moisesStevend/Health-Recover/README.md

# Health-Recover
Proyecto Health Recover

_Desarrollo de un sistema de IoT para la adherencia a la terapia de
 rehabilitación en personas con ACV
 Laboratorio de Innovación en Salud - UPCH_

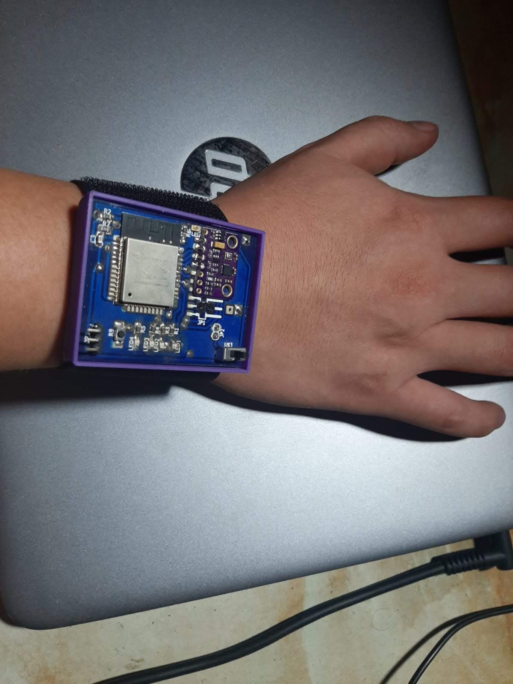
[picture p1: EVIDENCIAS/fotos/HR_fotos/health_recover.jpg]
Health Recover
