moisesStevend/Health-Recover/DOCUMENTOS/informes/ppt/pres_serendipity.pdf

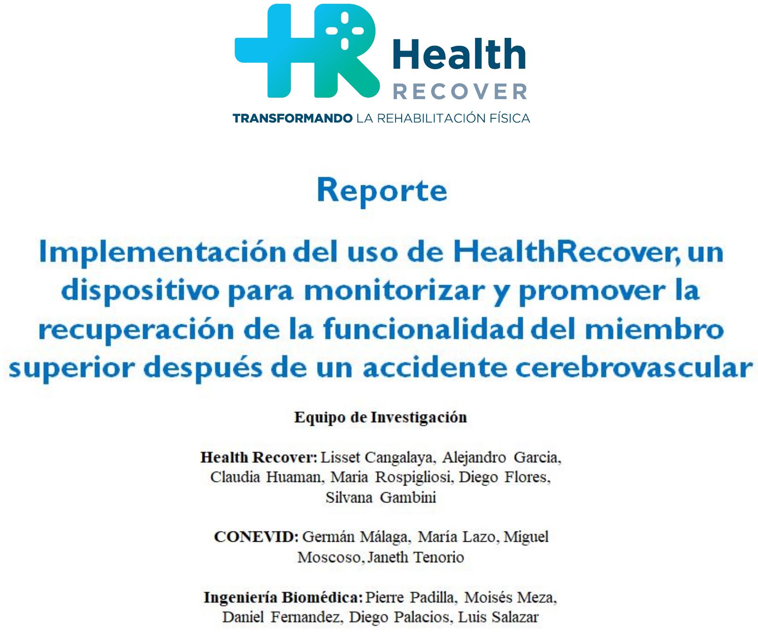
[picture p2: page 1]

# Nueva propuesta de tecnología wearable para Health Recover

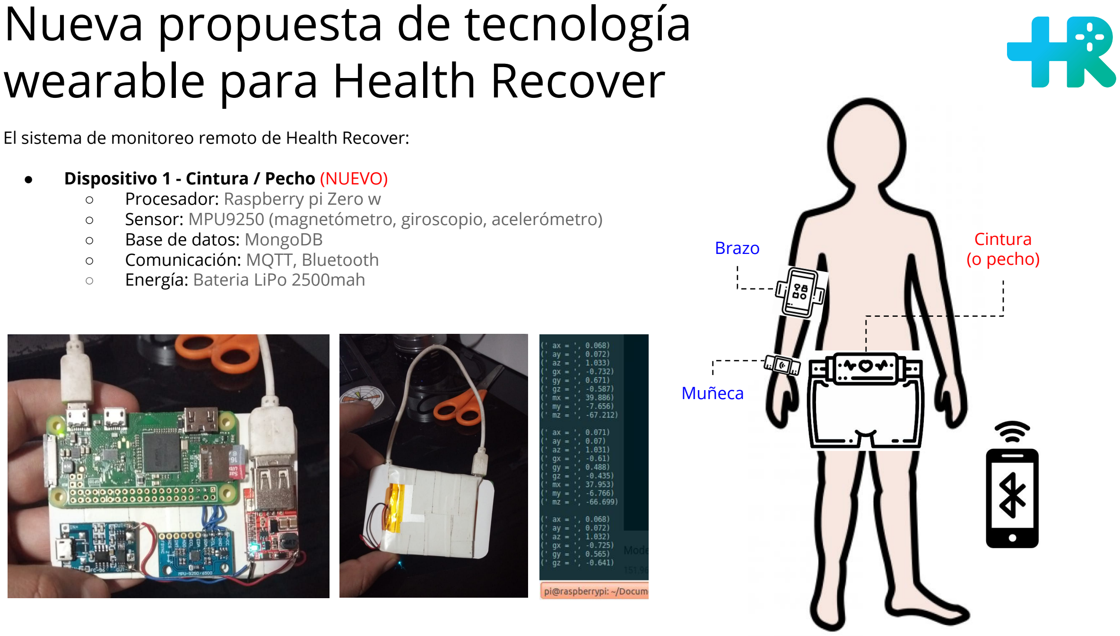
[picture p3: page 2]

El sistema de monitoreo remoto de Health Recover:

- Dispositivo 1 - Cintura / Pecho (NUEVO)
- Procesador: Raspberry pi Zero w
- Sensor: MPU9250 (magnetómetro, giroscopio, acelerómetro)
- Base de datos: MongoDB
- Comunicación: MQTT, Bluetooth
- Energía: Bateria LiPo 2500mah

Cintura
(o pecho)

Muñeca

Brazo

# Nueva propuesta de tecnología wearable para Health Recover

El sistema de monitoreo remoto de Health Recover:

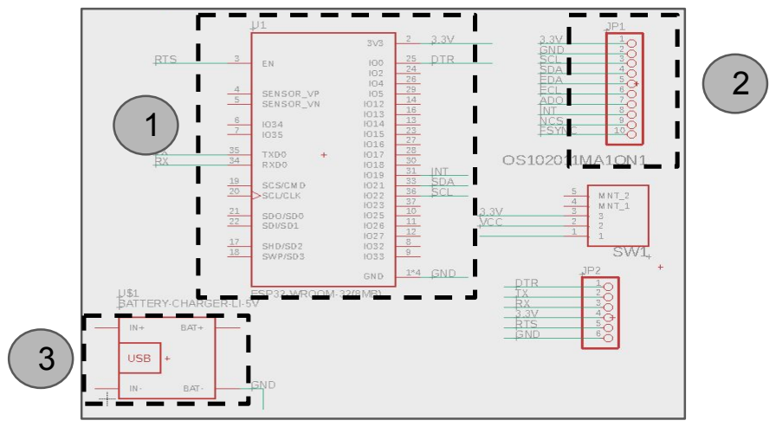
[picture p4: figure]

- Dispositivo 2 - Brazo (ACTUALIZADO)
- Procesador: ESP8266 (1)
- Sensor: MPU9250 (2 - sólo conectores)
- Comunicación: MQTT
- Energía: Bateria LiPo 1000mah (3 - sólo conectores)
- Dispositivo 3 - Muñeca (ACTUALIZADO)

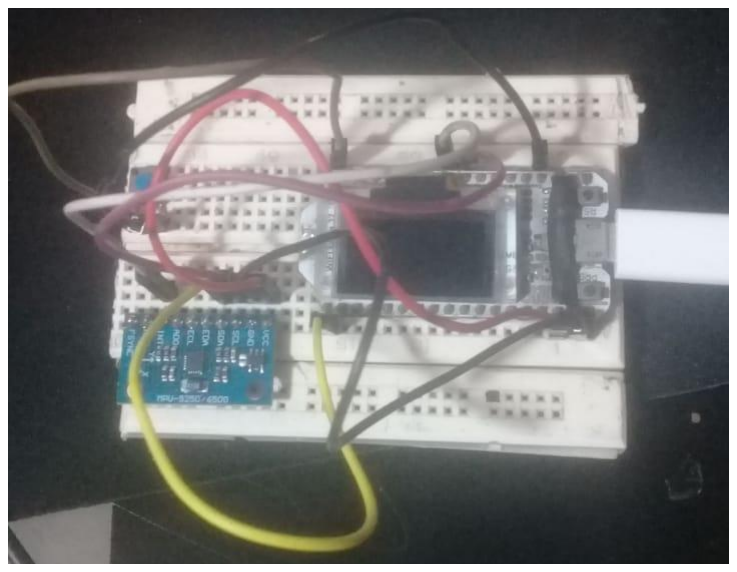
[picture p5: figure]
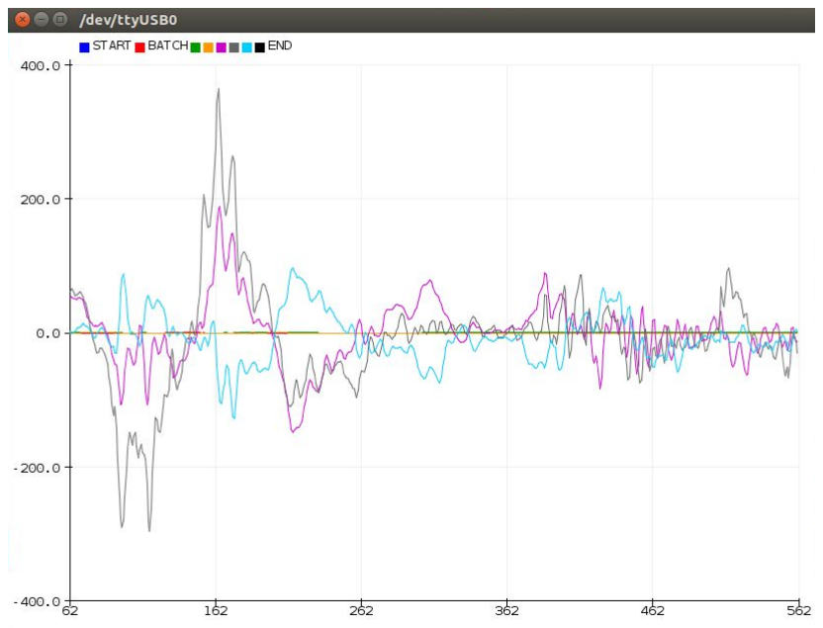
[picture p6: figure]
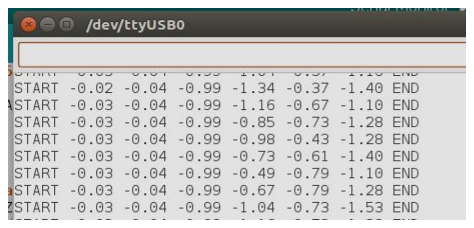
[picture p7: figure]

- Procesador: ESP8266
- Sensor: MPU9250
- Comunicación: MQTT

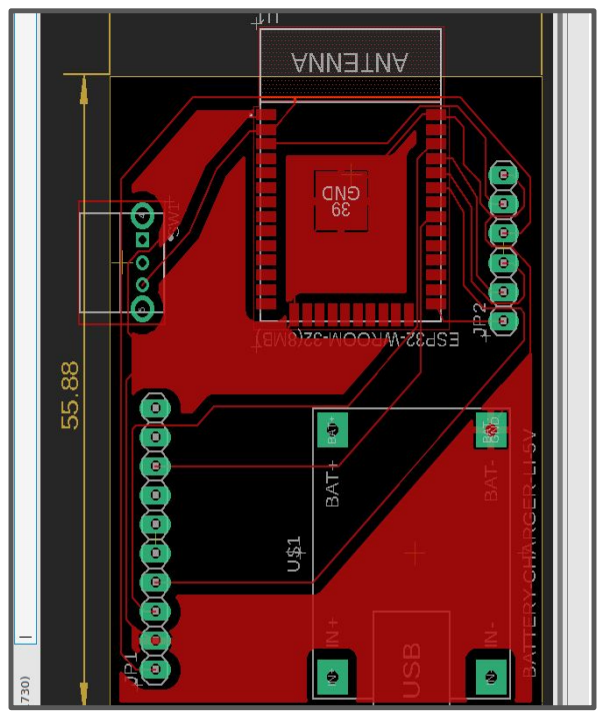
[picture p8: figure]

- Energía: Bateria LiPo 1000mah

52 mm

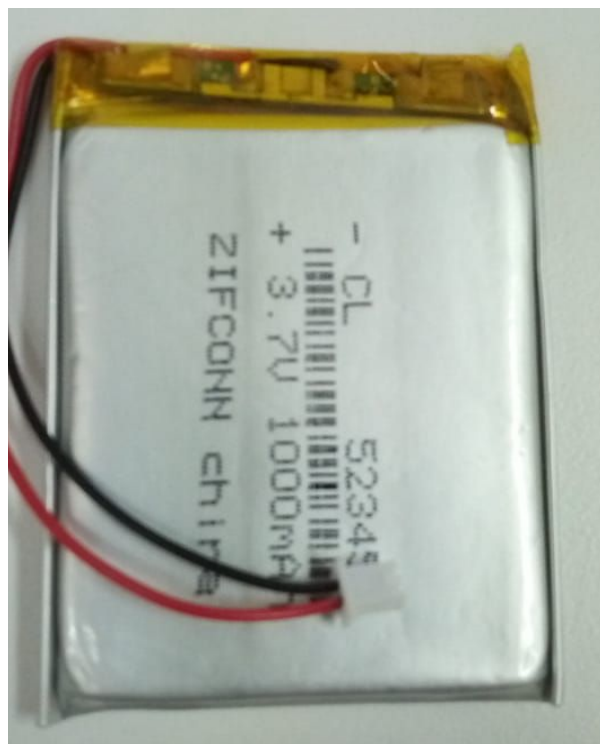
[picture p9: figure]

35 mm

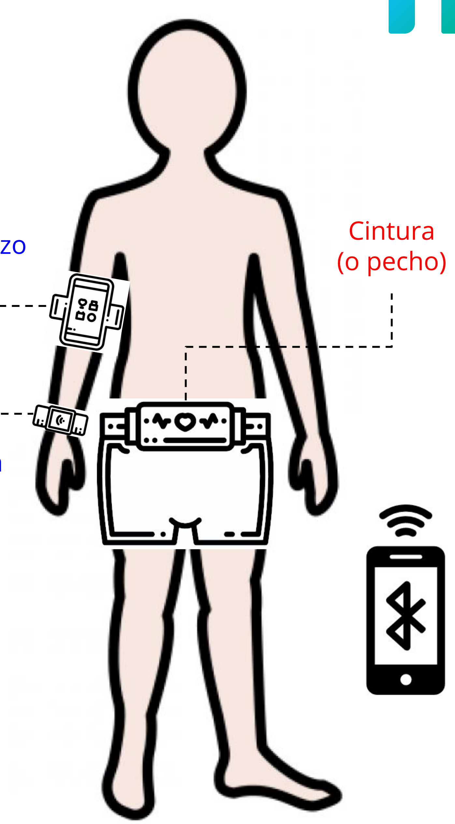
[picture p10: figure]
Cintura (o pecho)

Muñeca

Brazo

## Referencias

SWORD Health [Internet]. SWORD Health. 2019 [cited 2019 Dec 9]. Available from: https://swordhealth.com/

Kickstarter. FIVIS: Wearable Sensor Belt Helps You Develop Proper Posture [Internet]. 2019 [cited 2019 Dec 9]. Available from: https://www.kickstarter.com/projects/thecore/fivis-weak-core-bad-posture-and-back-p ain-relief-solution (https://www.kickstarter.com/projects/thecore/fivis-weak-core-bad-posture-and-back-pain-relief-solution)

Kickstarter. Flexr: Control Technology with Your Muscles [Internet]. 2019 [cited 2019 Dec 9]. Available from:
https://www.kickstarter.com/projects/1492366788/flexr-control-technology-with-yourmuscles (https://www.kickstarter.com/projects/1492366788/flexr-control-technology-with-your-muscles)

Kickstarter. 1Coach: Wearable that trains you to run like a Pro [Internet]. 2019 [cited 2019 Dec 9]. Available from: https://www.kickstarter.com/projects/46265006/1coach-your-personal-ai-powered-ru nning-coach (https://www.kickstarter.com/projects/46265006/1coach-your-personal-ai-powered-running-coach)

Chien C, Xia J, Santana O, Wang Y, Pottie GJ. Non-linear complementary filter based upper limb motion tracking using wearable sensors. In: 2013 IEEE International Conference on Acoustics, Speech and Signal Processing. 2013. p. 963–7.

Miezal M, Taetz B, Bleser G. On Inertial Body Tracking in the Presence of Model Calibration Errors. Sensors. 2016 Jul;16(7):1132.

Ordóñez FJ, Roggen D. Deep Convolutional and LSTM Recurrent Neural Networks for Multimodal Wearable Activity Recognition. Sensors. 2016 Jan;16(1):115.
