moisesStevend/Health-Recover/DOCUMENTOS/informes/mensuales/nov.pdf

avances meses Octubre-Noviembre Elaborado por Moises Stevend Meza Rodriguez

Se ha realizado lo siguiente:

## Octubre

Semana 01:
- Se probó un enlace mqtt entre los 2 esp8266, verificando que trabajen conjuntamente.
- Se probó el software ROS en ubuntu 18, pero no se obtuvo avances ya que el software no contaba con compatibilidad con la kinect v1
- Se probóC# por se el lenguaje que mantiene compatibilidad con la kinect v1. Este lenguaje nos podría servir si queremos algún punto en particular.
- Se instaló C# en visual studio y se procedió a programar un script de reconocimiento de trayectorias.

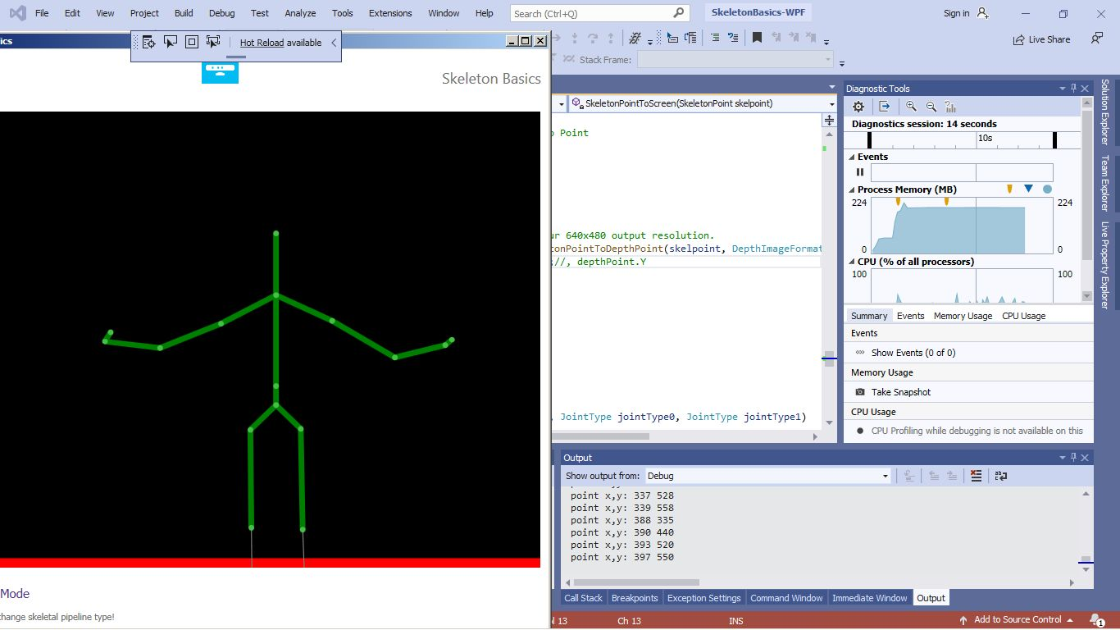
[picture p19: figure]

FIG.1- Esqueleto mediante líneas y puntos mediante C#

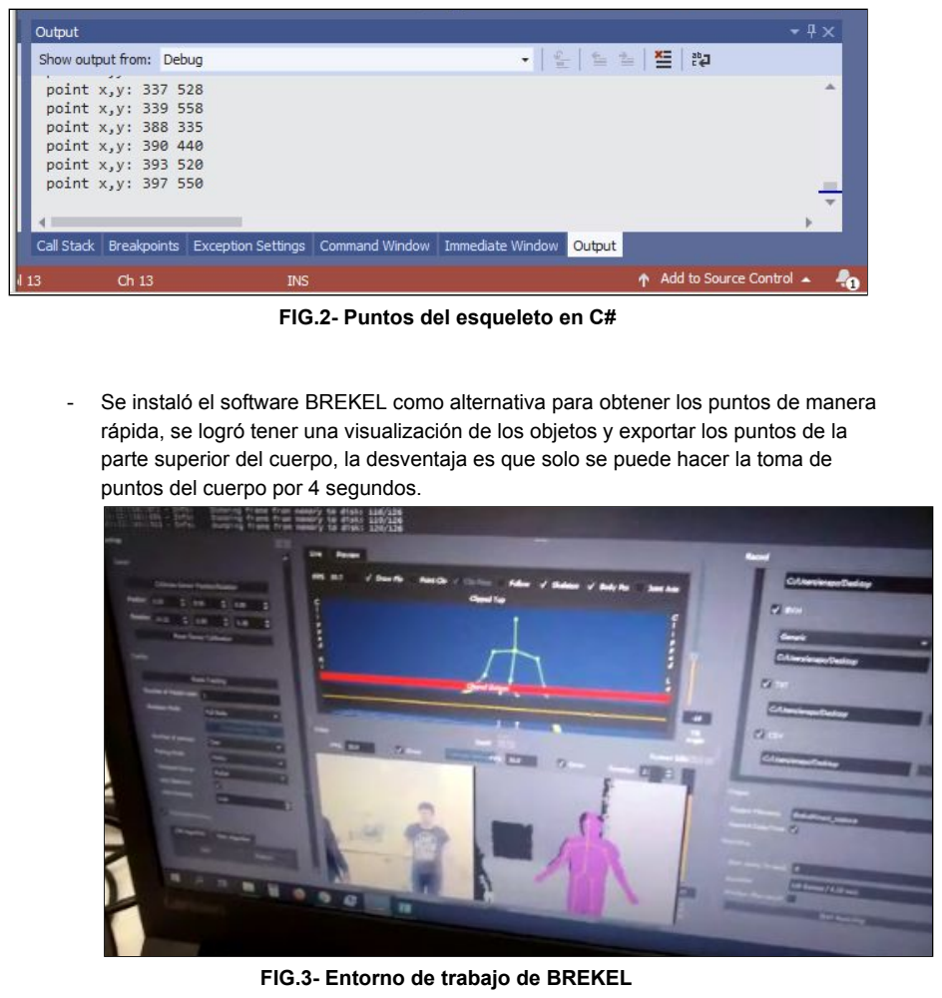
[picture p20: page 2]

FIG.2- Puntos del esqueleto en C#

- Se instaló el software BREKEL como alternativa para obtener los puntos de manera rápida, se logró tener una visualización de los objetos y exportar los puntos de la parte superior del cuerpo, la desventaja es que solo se puede hacer la toma de puntos del cuerpo por 4 segundos.

FIG.3- Entorno de trabajo de BREKEL

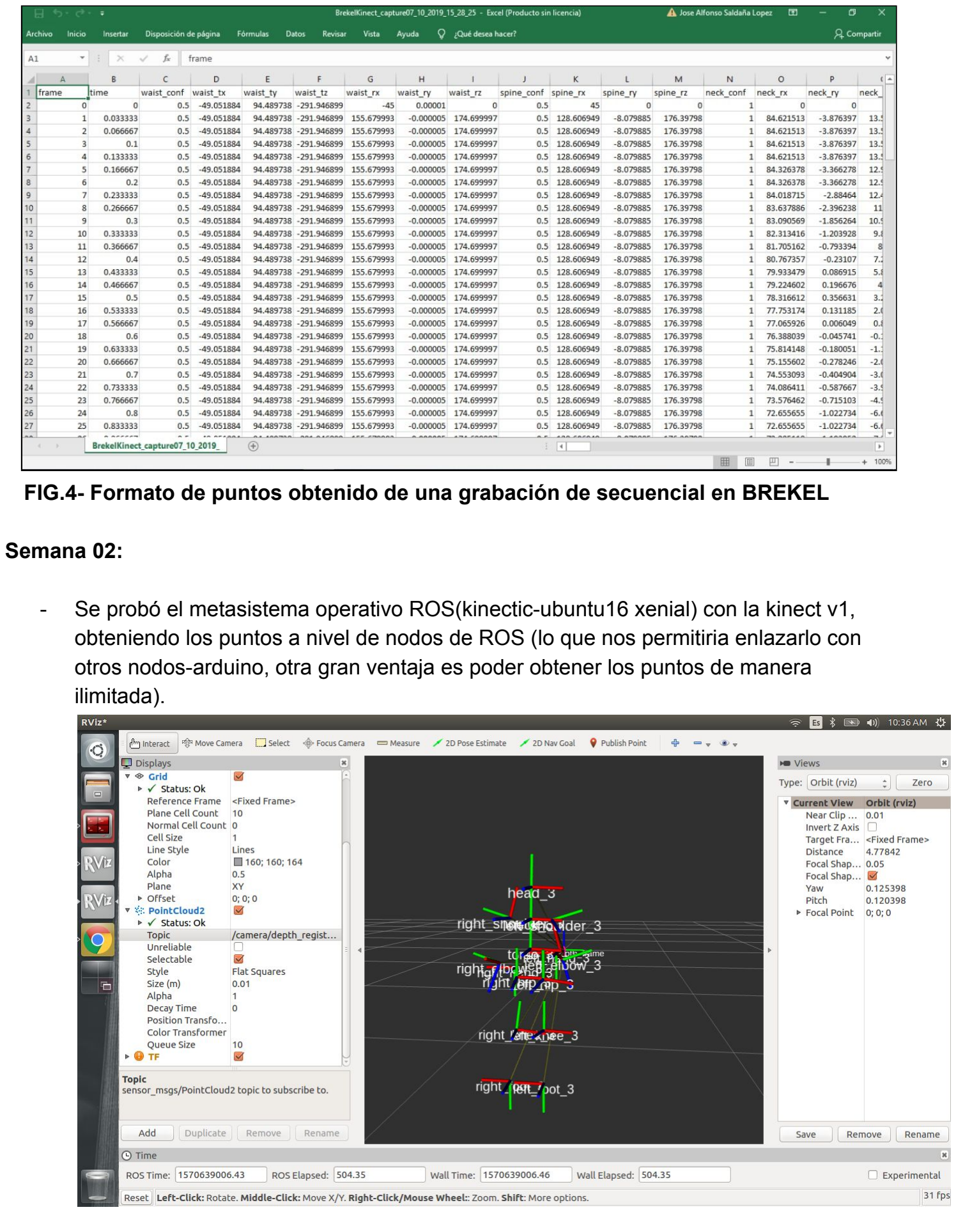
[picture p21: page 3]

FIG.4- Formato de puntos obtenido de una grabación de secuencial en BREKEL

Semana 02:

- Se probó el metasistema operativo ROS(kinectic-ubuntu16 xenial) con la kinect v1, obteniendo los puntos a nivel de nodos de ROS (lo que nos permitiria enlazarlo con otros nodos-arduino, otra gran ventaja es poder obtener los puntos de manera ilimitada).

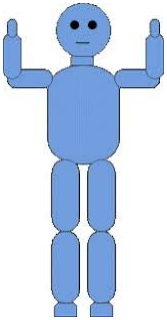
[picture p22: figure]

Fig .- Posición de inicio: “Pose PSI”

Se deja algunos enlaces usados:
- https://www.reddit.com/r/ROS/comments/6qejy0/openni_kinect_installation_on_kinetic_indigo/ (https://www.reddit.com/r/ROS/comments/6qejy0/openni_kinect_installation_on_kinetic_indigo/)
- https://answers.ros.org/question/10325/how-do-i-run-the-openni_tracker/
- http://dougsbots.blogspot.com/2012/02/ros-kinect-skeleton-tracking.html
- https://github.com/arnaud-ramey/NITE-Bin-Dev-Linux-v1.5.2.23
- http://mitchtech.net/ubuntu-kinect-openni-primesense/
- Se probó el MYo-armband y se obtuvo los valores del IMU en ROS kinetic.

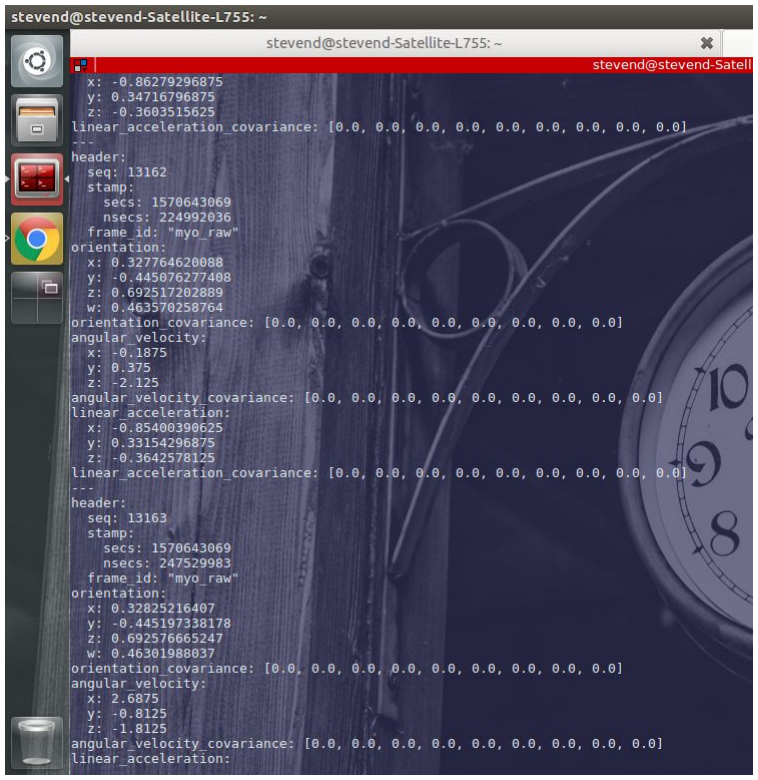
[picture p23: figure]

Fig Datos obtenidos de la MYO ARM band

- Adquisición de datos del mpu mediante mqtt con la laptop.
- Se tuvo una reunión sobre las modificaciones que tendrá las futuras versiones.
- Se instaló raspbian en la raspberry pi3
- Se creó un script para adquirir datos del mpu6050

Datos raspberry pi3:

❖ Red wifi: LAB.ING.BIOMEDICA
❖ Acceso via ssh: ssh -X pi@healthrecoverpi ❖ Username: pi
❖ Password: MicroRobotica19

semana 03:

- Se hizo una pcb para la conexión entre mpu6050 y rpi3
- Se optó por rediseñar el dispositivo para un mejor control de trayectorias, basado en un esp32 y un mpu9250.
- Se diseñó la nueva arquitectura de comunicación de los dispositivos hardware y el smartphone.

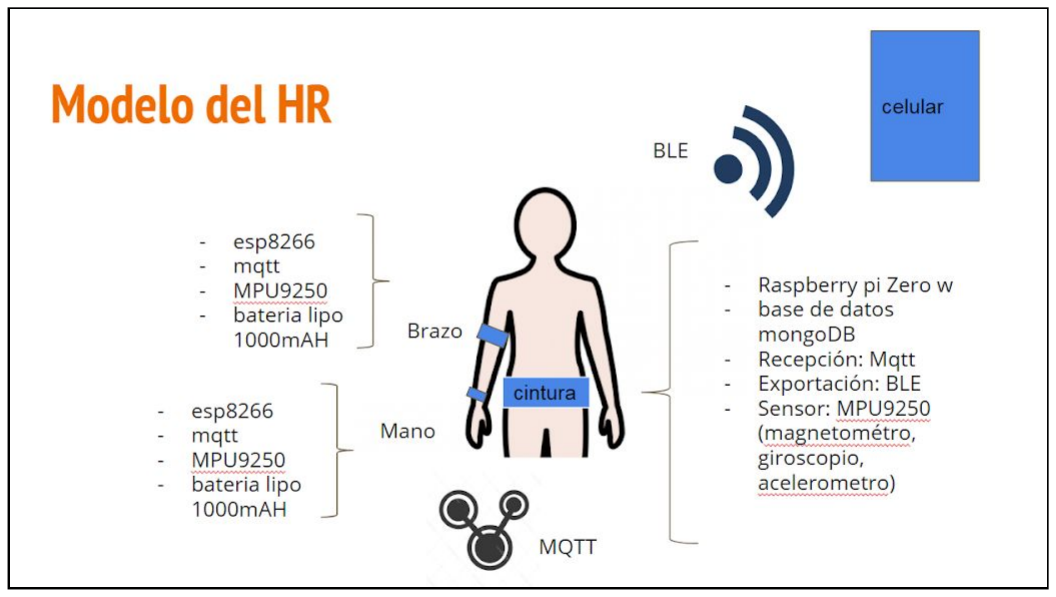
[picture p24: figure]

Fig. Nuevo movelo del HR

Semana 4:

- Pruebas de enlace entre el raspberry pi y los nodos del health recover.
- Se probó la instalación del ROS en el raspberry pi.
- Se analizó la identificación de patrones en WEKA
- Se analizó la Visualización de Datos en Python
- Se analizó la Base de Datos en MongoDB
- Se realizaron las compras para el nuevo dispositivo.

## Noviembre

Semana 1
- Se coordino las compras restantes.
- Se validó el nuevo modelo de hardware
- Se instaló ROS es el raspberry pi zero

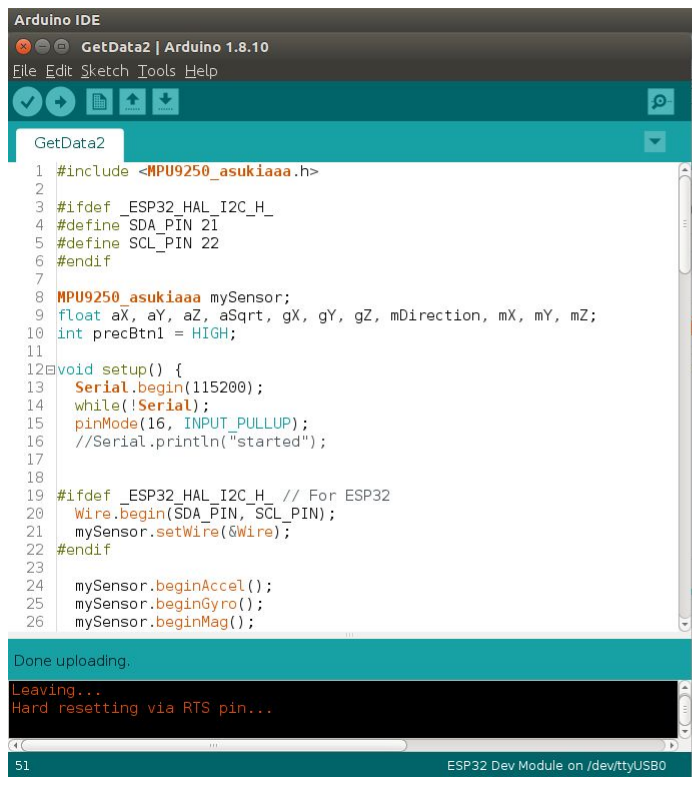
[picture p25: figure]
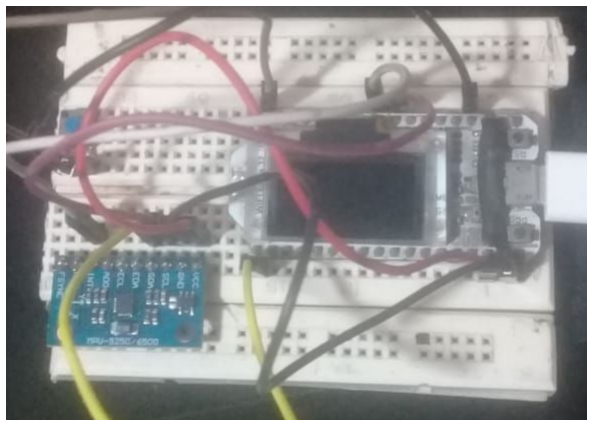
[picture p26: figure]

Fig.- Código base y circuiteria para el esp32 y el mpu9250 Semana 2:
- Se analizo patrones de la data obtenida del mpu9250
- Se empezó a implementar algoritmos de IA para obtener secuancias de movimientos.

Semana 3:
- Se realizo el diseño de la versión 2 del HR en eagle, se desarrolló en un modelo de 2 capas para los nodos del brazo.

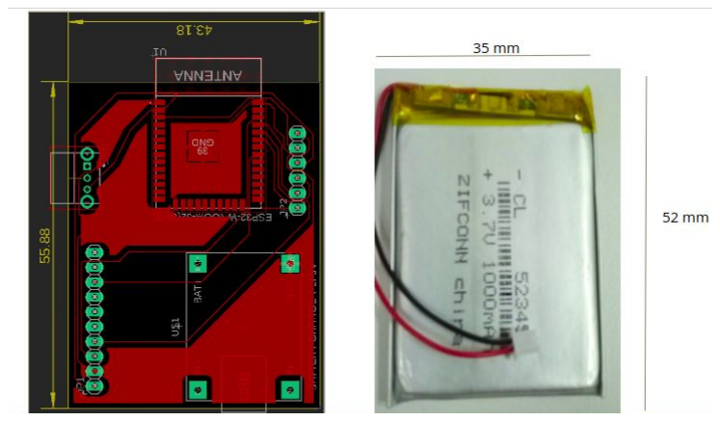
[picture p27: figure]

Fig.- Diseño del PCB para los nodos del brazo.

semana 4:
- Desarrollo del prototipo de HR - cintura.
- Adquisición de valores de los nodos.
- Prueba de todos los algorithmos desarrollados hasta la fecha en ela raspberry pi zero w.

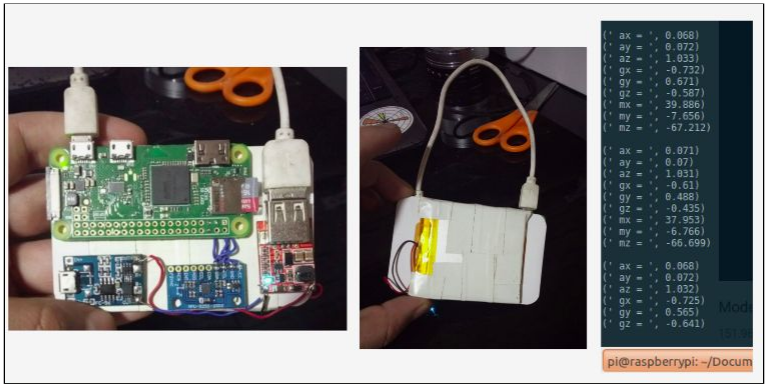
[picture p28: figure]

Fig.- Circuiteria del nodo central y adquisición de datos de su mpu9250

## Resumen

Desarrollo del hardware.-
En cuanto al desarrollo del hardware se opto por pasar el dispositivo central esp8266 a un esp32, además se opto por cambiar el mpu6050 por un mpu9250. Se completo la verificación de la comunicación y se desarrollo un modelo de pcb en eagle para la parte de los nodos del brazo. Se optó por adicionar un nodo central para mejorar el procesamiento de los datos, este nodo central esta basado en una raspberry pi zero w. Se desarrollo un esquema electrónico para la comunicación entre el raspberry pi, mpu9250 y la electronico suficiente para el buen desempeño.

Grabación de movimientos.-
Se opto por trabajar con el metasistema operativo ROS(Robotics Operating System) y la Kinect v1.0 para la optención de los movimientos y su análisis.

Compra de componentes para tarjetas. Se llego a completar las compras para esta segunda versión del HR. Se requerira componentes adicionales para la versión final del pcb.

Grabaciones de movimientos.-
Se grabó unas secuencias mediante ROS y Knect y se estuvo prograbando el reconocimiento de patros, también se completo los códigos de programación para los nodos del brazo. El algorithmo aún esta en depuración.
