moisesStevend/Health-Recover/DOCUMENTOS/informes/mensuales/set_oct.pdf

### Informe de Avances Moises Stevend Meza Rodriguez

Dia 28/09/19
- Se tuvo una conversación con el desarrollador de la aparte de hardware del Health-Recover Joaquín Verastegui.
- Se analizó los esquemáticos del hardware.
- Se comprobó el funcionamiento del hardware.
- Se puso operativo las tarjetas Health-Recover.
- Se analizó la arquitectura de comunicación del proyecto.

Día 30/09/19
- Se monitoreo el avance según el cronograma establecido.
- Se coordino el uso de la plataforma para programar los algoritmos.

Día 1/10/19
- Se probó la kinect con su sdk y el toolkit developer 1.8.
- Se empezó a probar enlazarlo con algún lenguaje de programación para obtener los puntos, se empezo con pykinect pero no se obtuvo los resultados esperados.

Día 2/10/19
- Se probó diferentes lenguajes para obtener los puntos, pero no se logró enlazar a ningún lenguaje.

Día 3/10/19
- Se probó un enlace mqtt entre los 2 esp8266,verificando que trabajen conjuntamente.

Día 4/10/19
- Se probó el software ROS en ubuntu 18, pero no se obtuvo avances ya que el software no contaba con compatibilidad con la kinect v1

Día 5/10/19
- Se tuvo una reunión para ver el seguimiento de los proyectos según el cronograma.
- Se instaló ubuntu12.04 para probar la versión libre de la kinect, no se obtuvo avances ya que no existe soporte para esa versión de ubuntu.

Día lunes 07/10/19
- Se instaló diferentes drivers para el reconocimiento del sdk-kinect modo developer, con el fin de poder programarla, se uso windows como sistema operativo.

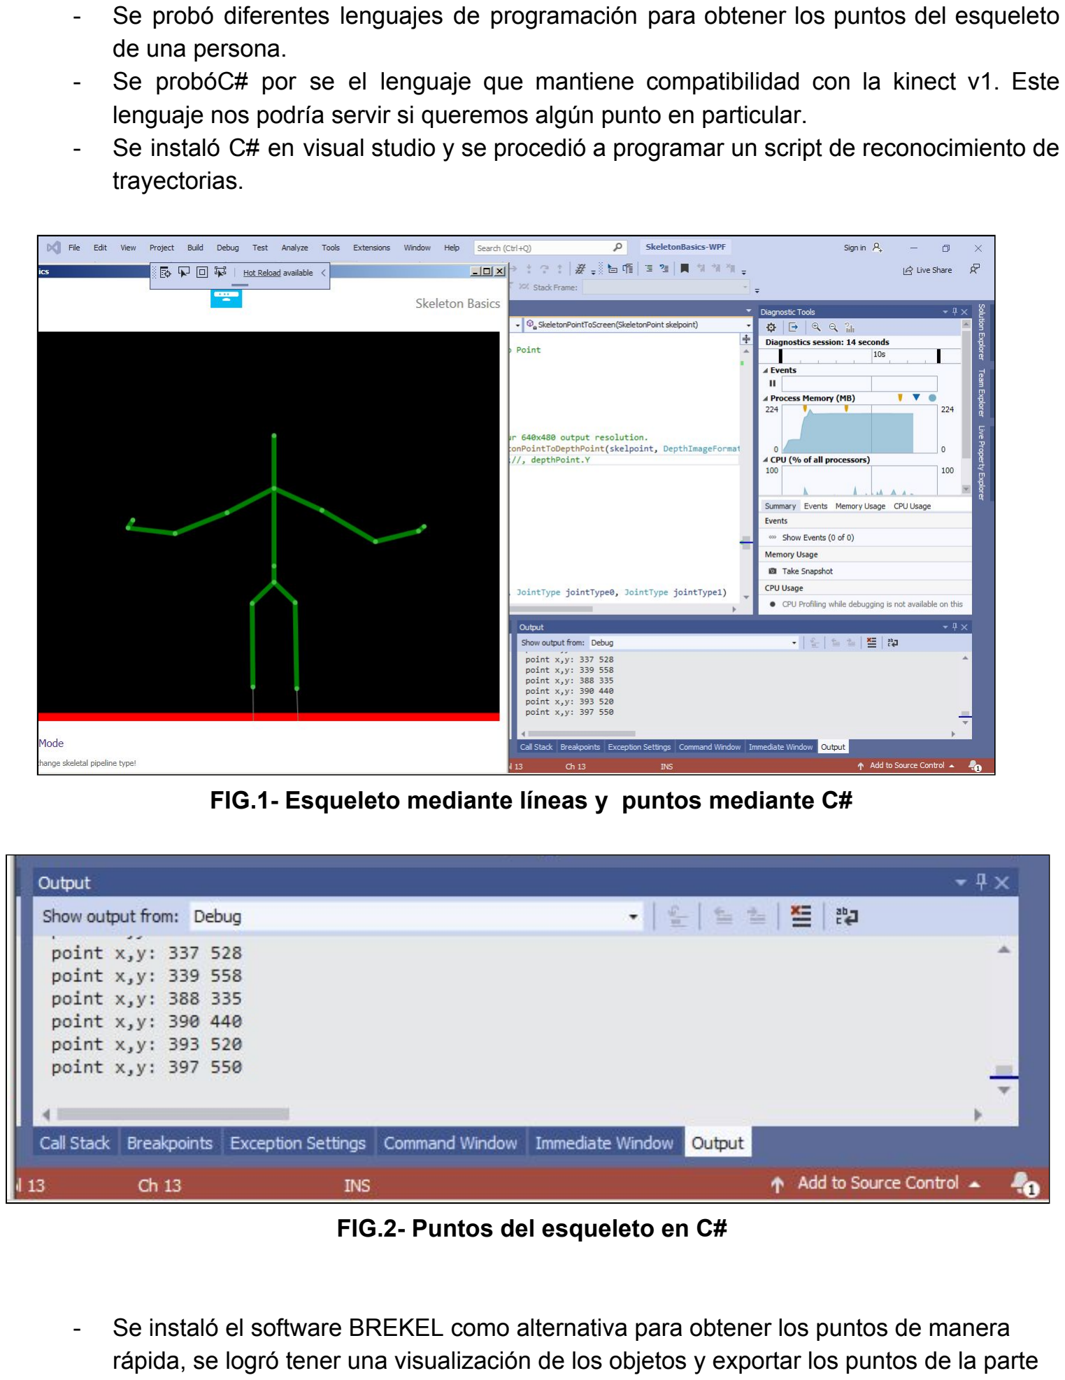
[picture p29: page 2]

- Se probó diferentes lenguajes de programación para obtener los puntos del esqueleto de una persona.
- Se probóC# por se el lenguaje que mantiene compatibilidad con la kinect v1. Este lenguaje nos podría servir si queremos algún punto en particular.
- Se instaló C# en visual studio y se procedió a programar un script de reconocimiento de trayectorias.

FIG.1- Esqueleto mediante líneas y puntos mediante C#

FIG.2- Puntos del esqueleto en C#

- Se instaló el software BREKEL como alternativa para obtener los puntos de manera rápida, se logró tener una visualización de los objetos y exportar los puntos de la parte

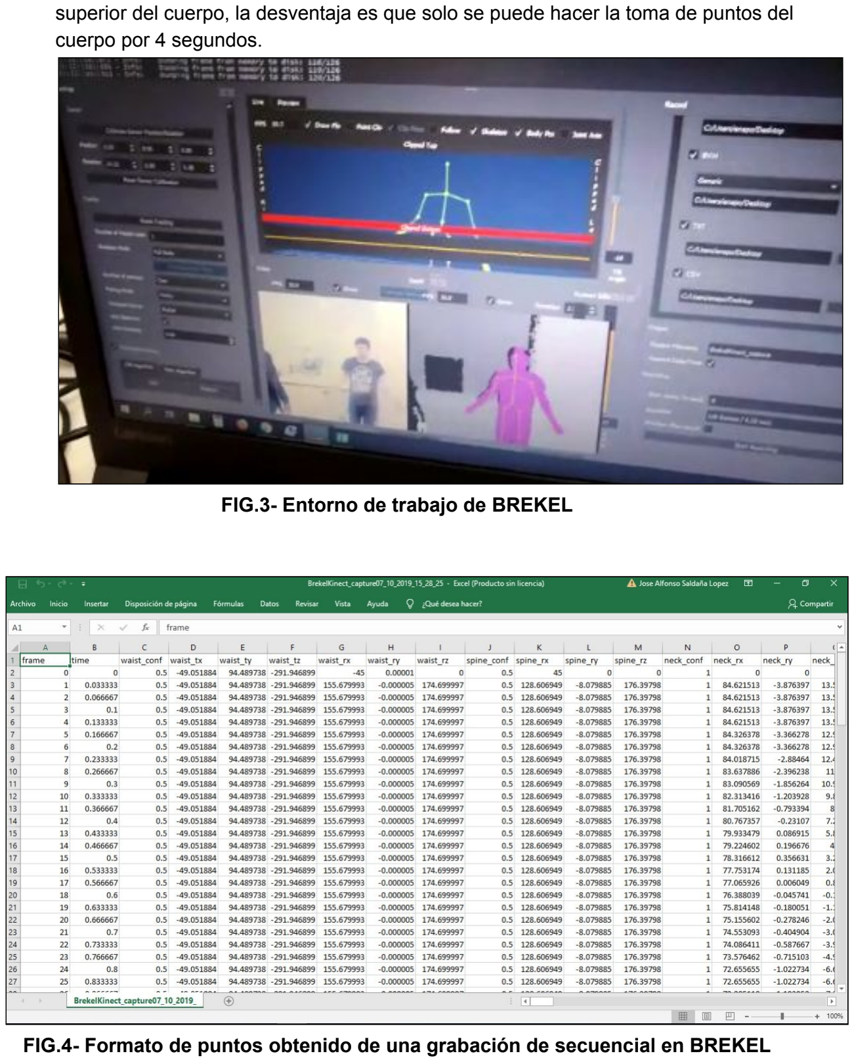
[picture p30: page 3]

superior del cuerpo, la desventaja es que solo se puede hacer la toma de puntos del cuerpo por 4 segundos.

FIG.3- Entorno de trabajo de BREKEL

FIG.4- Formato de puntos obtenido de una grabación de secuencial en BREKEL

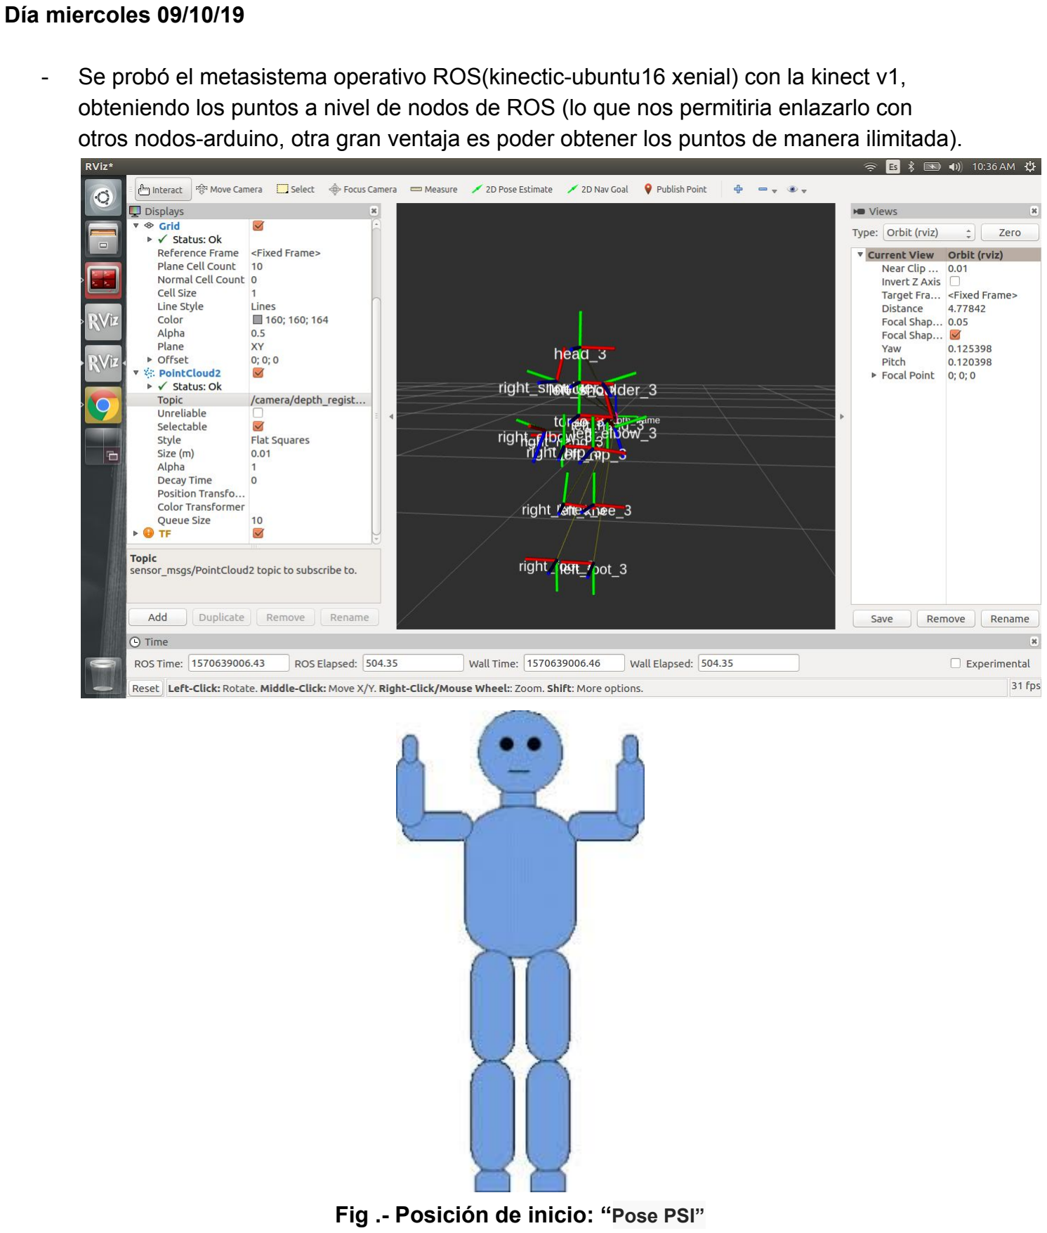
[picture p31: page 4]

Día miercoles 09/10/19

- Se probó el metasistema operativo ROS(kinectic-ubuntu16 xenial) con la kinect v1, obteniendo los puntos a nivel de nodos de ROS (lo que nos permitiria enlazarlo con otros nodos-arduino, otra gran ventaja es poder obtener los puntos de manera ilimitada).

Fig .- Posición de inicio: “Pose PSI”

Se deja algunos enlaces usados:
- https://www.reddit.com/r/ROS/comments/6qejy0/openni_kinect_installation_on_kinetic_indigo/ (https://www.reddit.com/r/ROS/comments/6qejy0/openni_kinect_installation_on_kinetic_indigo/)
- https://answers.ros.org/question/10325/how-do-i-run-the-openni_tracker/
- http://dougsbots.blogspot.com/2012/02/ros-kinect-skeleton-tracking.html
- https://github.com/arnaud-ramey/NITE-Bin-Dev-Linux-v1.5.2.23
- http://mitchtech.net/ubuntu-kinect-openni-primesense/
- Se probó el MYo-armband y se obtuvo los valores del IMU en ROS kinetic.

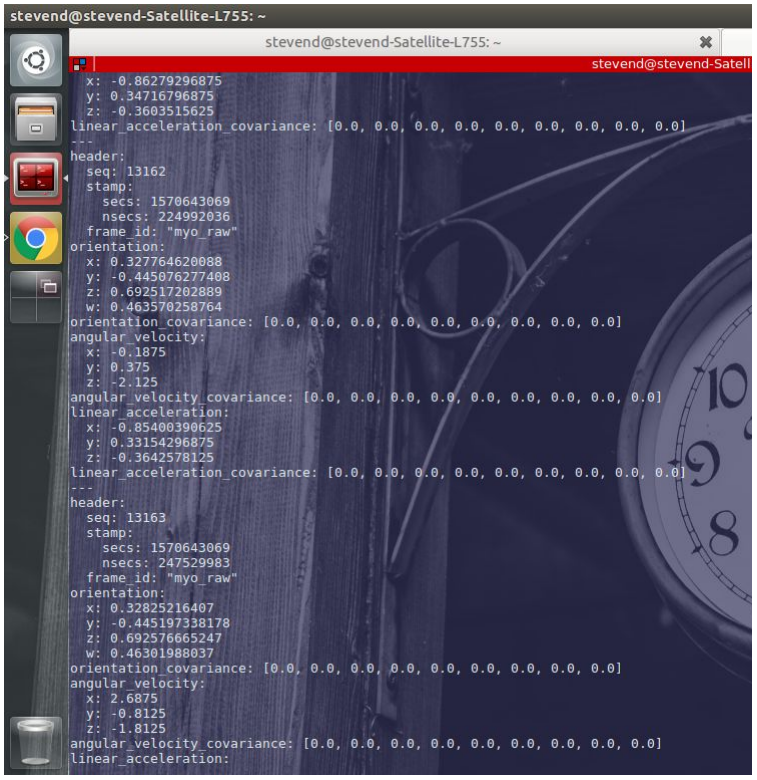
[picture p32: figure]

Día viernes 11/10/19

- Taller de sistemas operativos y linux.
- Instalación de ubuntu en PCs

Día martes 15/10/19

- Adquisición de datos del mpu mediante mqtt con la laptop.
- Se tuvo una reunión sobre las modificaciones que tendrá las futuras versiones.

Día jueves 17/10/19

- Se instaló raspbian en la raspberry pi3
- Se hizo un mini taller sobre raspberry pi
- Se creó un script para adquirir datos del mpu6050

Datos raspberry pi3:

❖ Red wifi: LAB.ING.BIOMEDICA
❖ Acceso via ssh: ssh -X pi@healthrecoverpi ❖ Username: pi
❖ Password: MicroRobotica19

Día jueves 18/10/19

- Se hizo una pcb para la conexión entre mpu6050 y rpi3

Día jueves 21/10/19

- Se optó por rediseñar el dispositivo para un mejor control de trayectorias, basado en un esp32.
- Se diseñó el circuito electrónico del esp32 con el IMU-9 grados de libertad.

Día jueves 22/10/19

- Se diseñó la nueva arquitectura de comunicación de los dispositivos hardware y el smartphone.

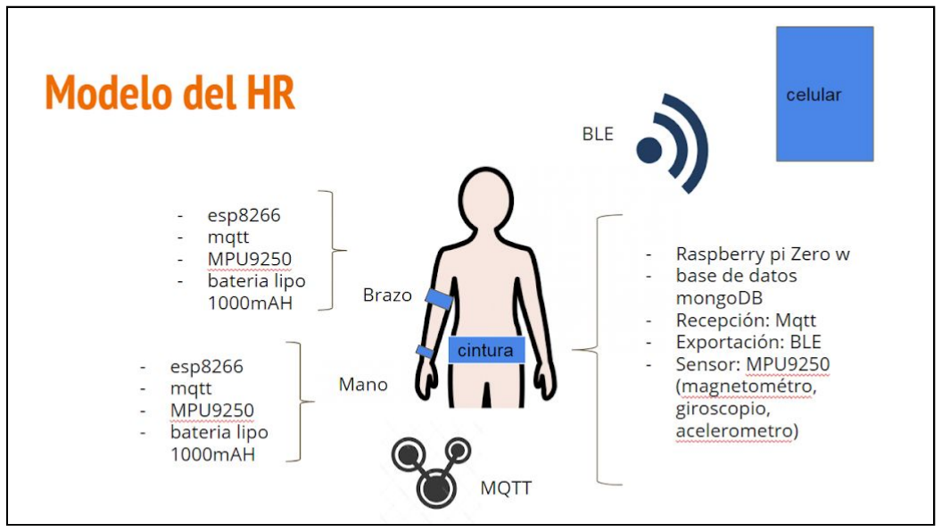
[picture p33: figure]

Día jueves 25/10/19

- Pruebas de enlace entre el raspberry pi y los nodos del health recover.
- Se probó la instalación del ROS en el raspberry pi.

Día jueves 26/10/19
- Reunión semanal de avances del proyecto.

Día jueves 28/10/19
- Se analizó la identificación de patrones en WEKA
- Se analizó la Visualización de Datos en Python
- Se analizó la Base de Datos en MongoDB

Día jueves 31/10/19
- Se realizaron las compras para el nuevo dispositivo.

*En los días no mencionados se leyó artículos y tesis relacionados al proyecto.
