moisesStevend/Health-Recover/DOCUMENTOS/informes/ppt/AVANCES HR.pdf

# AVANCES HR

### Moises Meza

# Avances

- Se compró los nuevos materiales para una reestructuración del HR.
- Se leyó artículos acorde a lo acordado.

### - Base de datos mongoDB con python

# Artículos

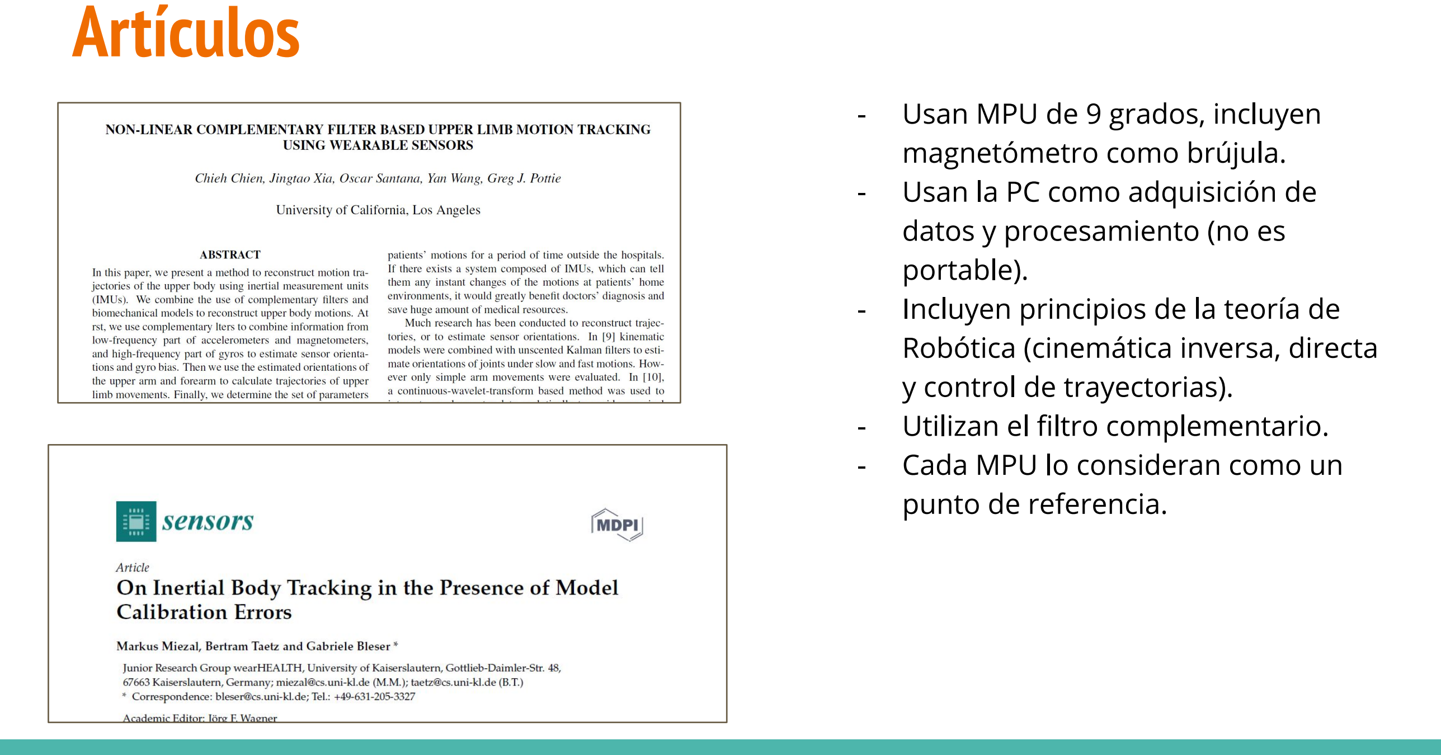
[picture p34: page 3]

- Usan MPU de 9 grados, incluyen magnetómetro como brújula.
- Usan la PC como adquisición de datos y procesamiento (no es portable).
- Incluyen principios de la teoría de Robótica (cinemática inversa, directa y control de trayectorias).
- | Utilizan el filtro complementario. - | Cada MPU lo consideran como un

punto de referencia.

# Artículos

- Obtienen los puntos usando ROS y una kinect 360.
- Usan Gazebo para la visualización de los puntos y crean un nodo para obtener los puntos de las articulaciones.
- Utilizan WEKA como software de análisis y le aplican técnicas de machine learning (recomiendan usar RANDOM FOREST).
- Utilizan C++ como lenguaje de análisis.

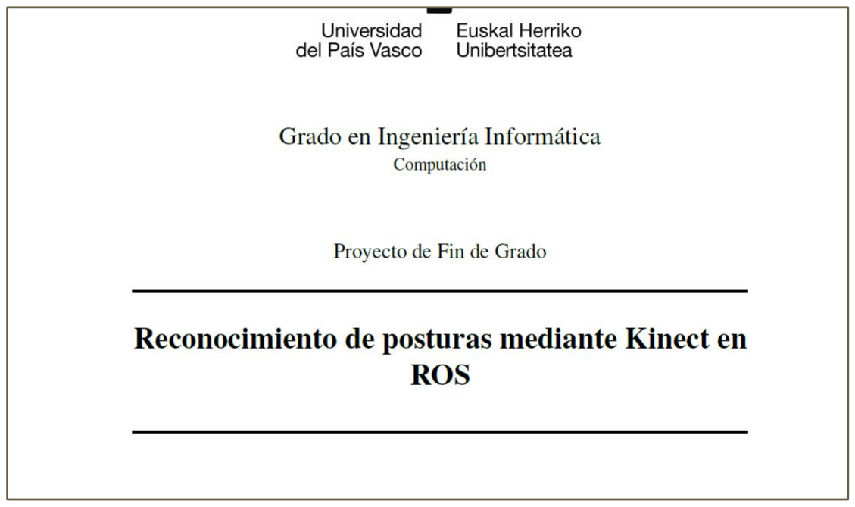
[picture p35: figure]

Modelo del HR | celular

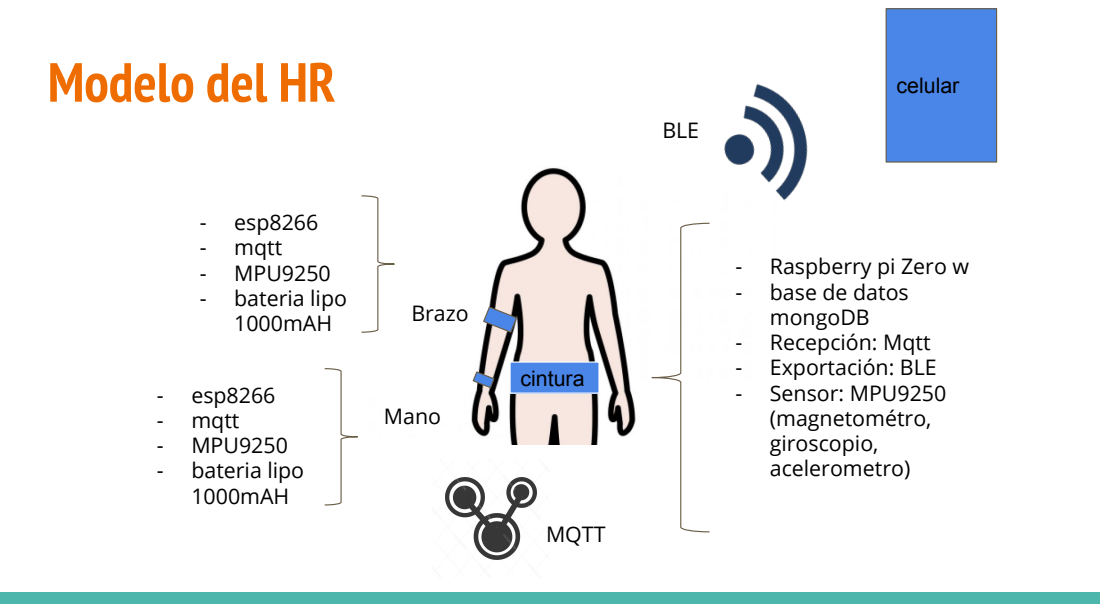
[picture p36: page 5]
cintura; Mano; Brazo; - esp8266 - mqtt - MPU9250 - bateria lipo 1000mAH; MQTT

BLE

- Raspberry pi Zero w
- base de datos
mongoDB
- Recepción: Mqtt
- Exportación: BLE
- Sensor: MPU9250
(magnetométro,
giroscopio,
acelerometro)

# Base de datos

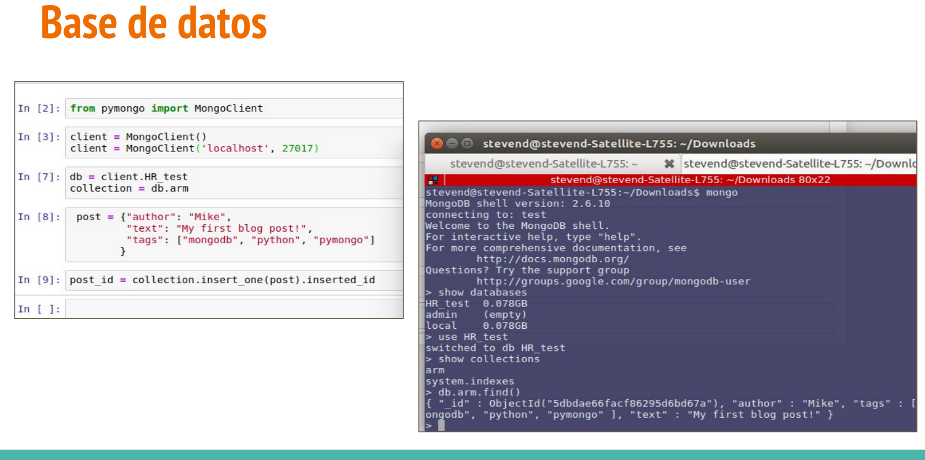
[picture p37: page 6]

# AVANCES HR

### Moises Meza

# Avances

- Se realizó una mini capacitación sobre Internet of Things, node-red, mqtt.
- Se coordino las compras restantes.

### - Se validó el nuevo modelo de hardware - Se instaló ROS es el raspberry pi zero

# Nuevo Modelo

### esp32

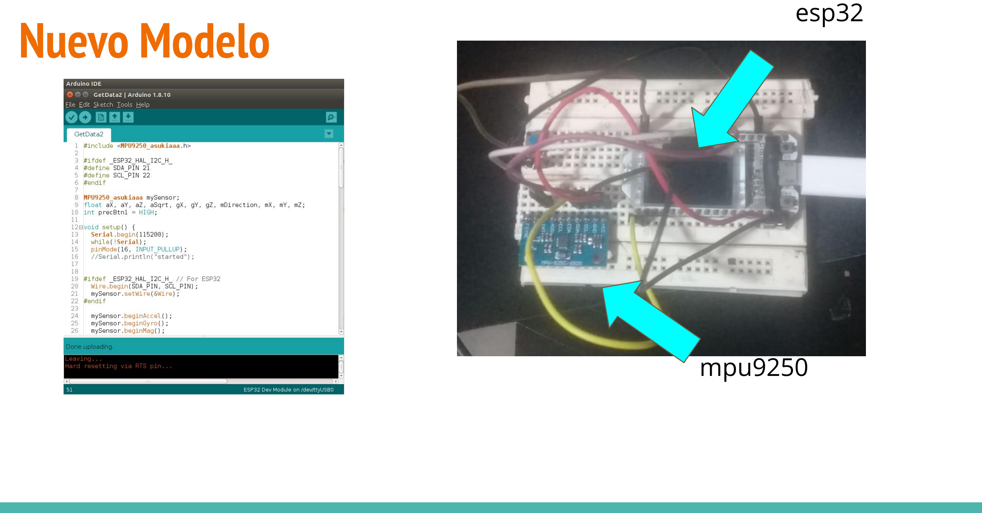
[picture p38: page 9]

### mpu9250

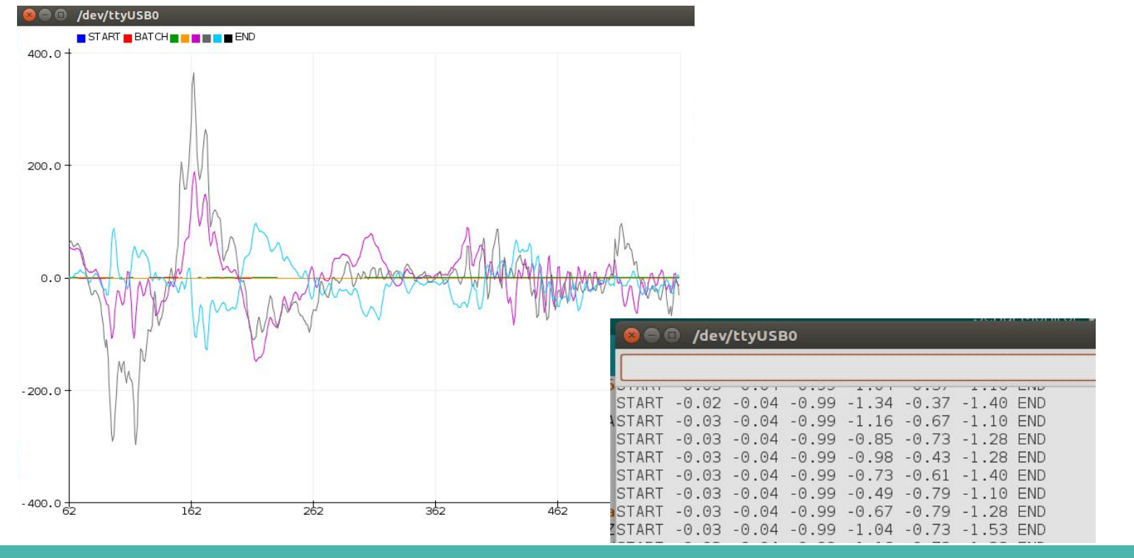
[picture p39: page 10]

# Modelo de ML

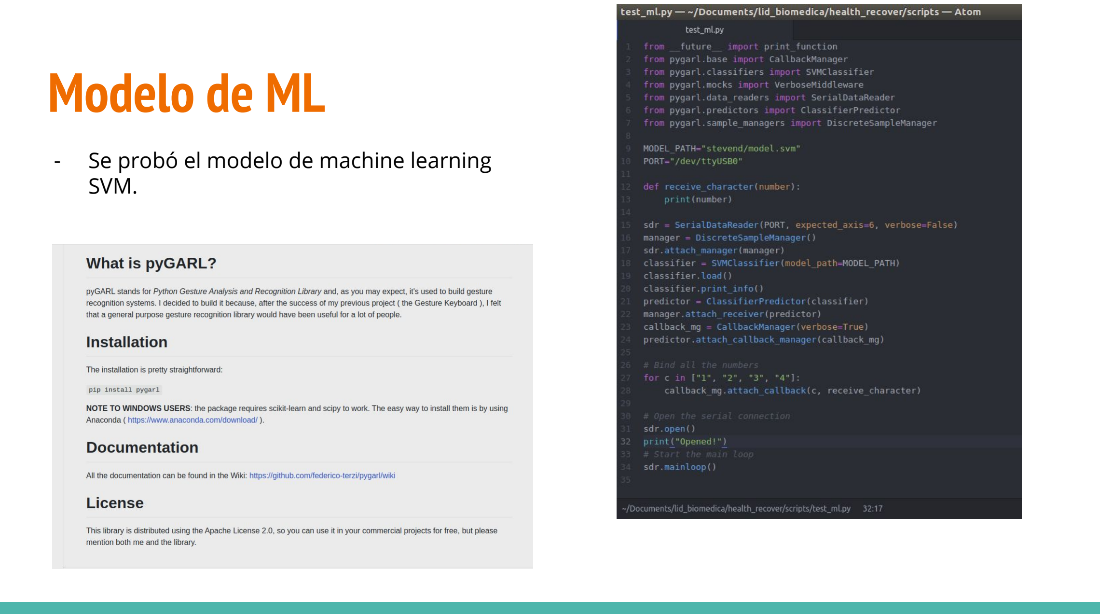
[picture p40: page 11]

- Se probó el modelo de machine learning SVM.

# AVANCES HR

### Moises Meza

# Avances

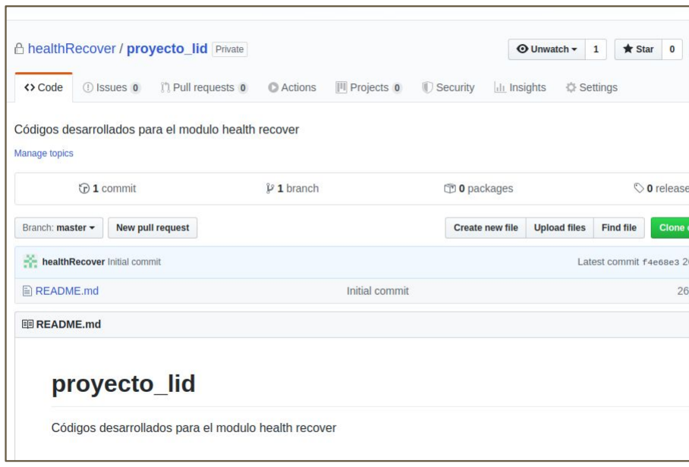
[picture p41: figure]

- Se realizó la compra final de componentes.

### - Se creó la cuenta en github:

https://github.com/healthRecover/proyecto_lid

### - Se avanzó con la interacción del esp32 - Enlace de la raspberry pi zero con mpu9250

# Interacción del HR

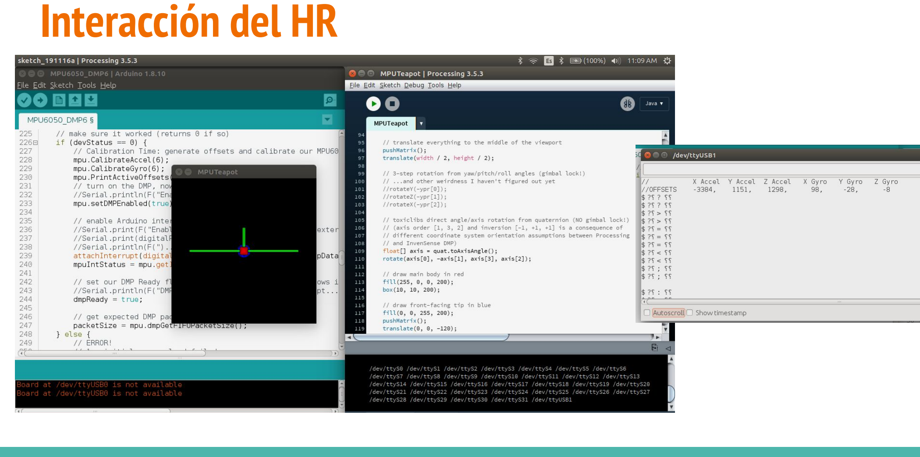
[picture p42: page 14]

# AVANCES HR

### Moises Meza

# Avances

### - Se realizó algoritmos de envío de data del esp32 y el mpu9250 usando

mqtt.

### - Se conectó con el unreal engine, sin embargo se necesita hacer mas

pruebas.

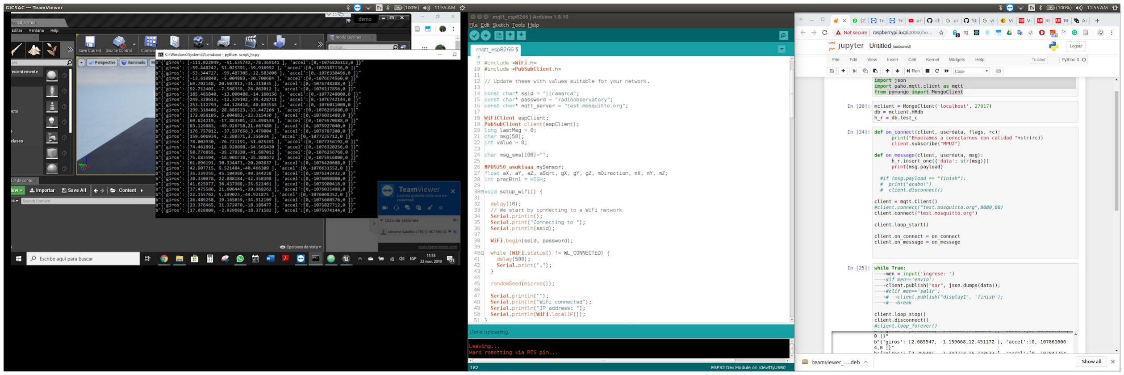
[picture p43: figure]

# AVANCES HR

### Moises Meza

# Desarrollo de la segunda versión del dispositivo

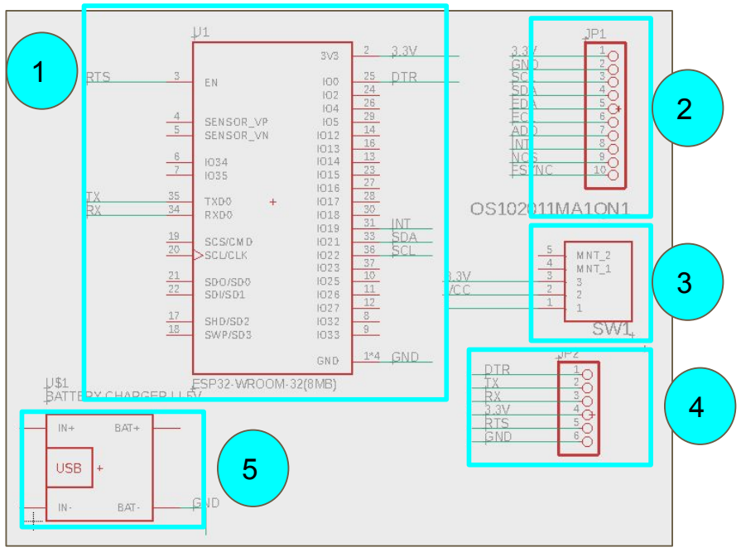
[picture p44: figure]

1: Esp32 modelo: wroom
2: MPU9250 (solo espadines) 3: micro slider switch 4mm
4: Pines para carga del firmware 5: Módulo cargador de batería

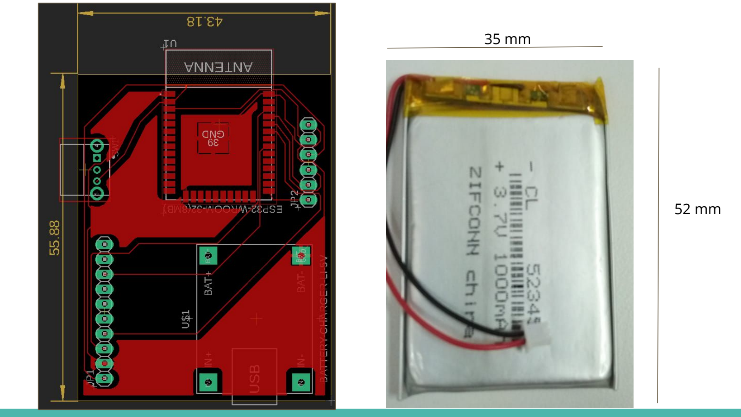
[picture p45: page 20]

52 mm

35 mm

# AVANCES HR

### Moises Meza

# Desarrollo del prototipo de HR - cintura

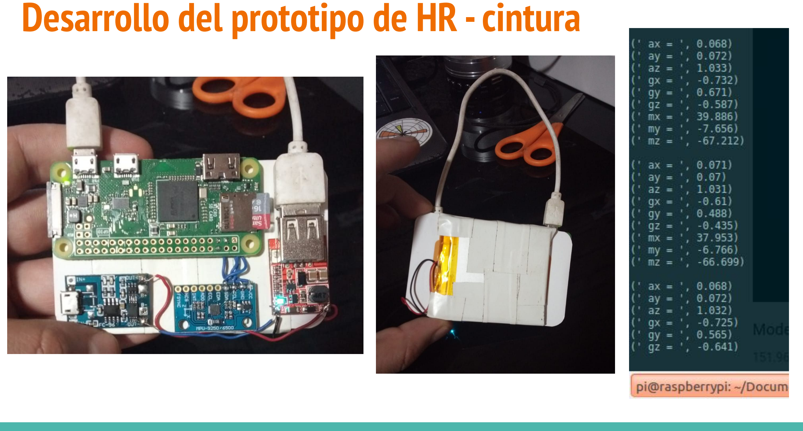
[picture p46: page 23]
