moisesStevend/Health-Recover/DOCUMENTOS/informes/mensuales/ene.pdf

### Informe de Avances Moises Stevend Meza Rodriguez

Semana 1.-

- Se optimizó el algoritmo de control de trayectorias usando posiciones relativas basados en el algoritmos de posiciones del los smartphones implementados en C++.
- Se corrigió las vías del circuito electrónico para que el hardware pueda tener un control de carga de batería optimizado.

Semana 2.-

- Se continuó con los algoritmos de trayectorias, y se agrego las funciones para capturar las 10 trayectorias asignadas al inicio.
- Se implementó una API en el microcontrolador ESP32 para la comunicación mediante Bluetooth con el smartphone (android).

Semana 3.-

- Se optimizó la API adicionando paquetes JSON (tramas de comunicación) con la versión actual del APP.
- Se tuvo una reunión con el personal encargado del desarrollo del APP del Health Recover y se procedió a entregar una versión actualizada del hardware para su evaluación de la comunicación con el APP.

Semana 4.-

- Se optimizó el algoritmos usando los dos núcleos del ESP32.
- Se coordinó para actualizar la versión actual modular a una versión superficial.

Observaciones.-

Se pudo probar el seguimiento de trayectorias con una buena fidelidad, pero para movimientos no tan cercanos a la trayectoria original pierde la secuencia, para ello es necesario hacer más pruebas y/o calibrar con más movimientos.
Cabe resaltar que durante el mes de enero se trabajó en el código mayormente, salvo las correcciones para la carga de batería.
Los códigos se subieron al github del proyecto (repositorio privado):

https://github.com/healthRecover/proyecto_lid

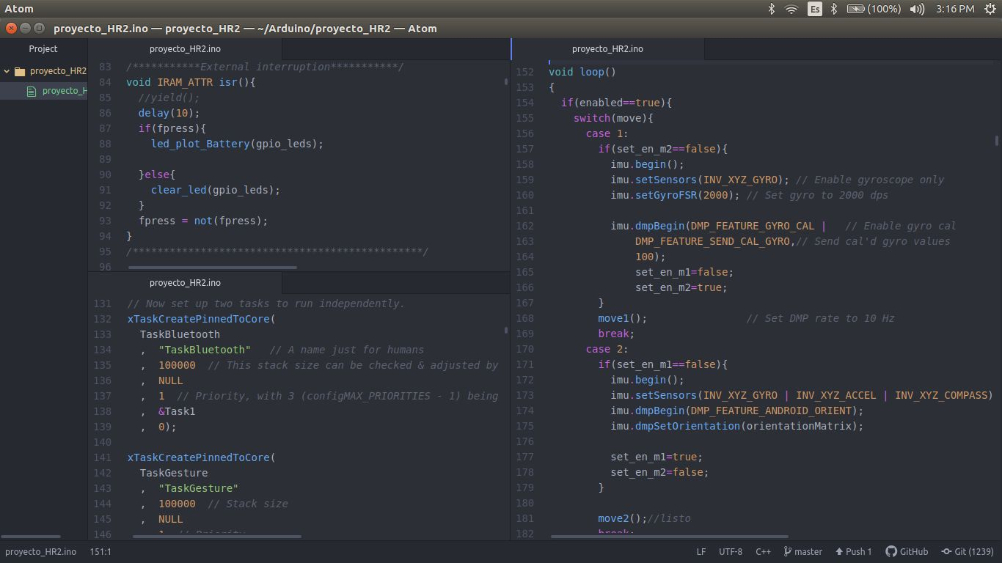
[picture p65: figure]

Fig 1.- Vista general del código en diferentes pantallas
