moisesStevend/Health-Recover/FRAMEWORK/tramas_hr.pdf

para enviar

status:

play: inicio de ejercicio, se debe enviar un json con el número de ejercicio
stop: puede enviarse de forma única en el json, para el conteo del ejercicio
get: puede enviarse de forma única en el json, obtiene la cantidad de ejercicios correctos exe: Se envía en conjunto con el status play, da al wearable el ejercicio a realizar.

ejemplo:

>> {‘status’: ‘play’, ‘exercise’: 2} →{'status': 'ok-play'}
>> {‘status’: ‘stop’}
→{'status': 'ok-stop'}
>> {‘status’: ‘get’}
→{'status': 'ok-get', ‘correctos’: 9, ‘porcentaje’: 50, ‘ejercicio’: 2}

en cualquier otro caso enviará:
→{'status': 'failed'}
