moisesStevend/Health-Recover/LOGISTICA/compras/prototipo grande/202002271531.pdf

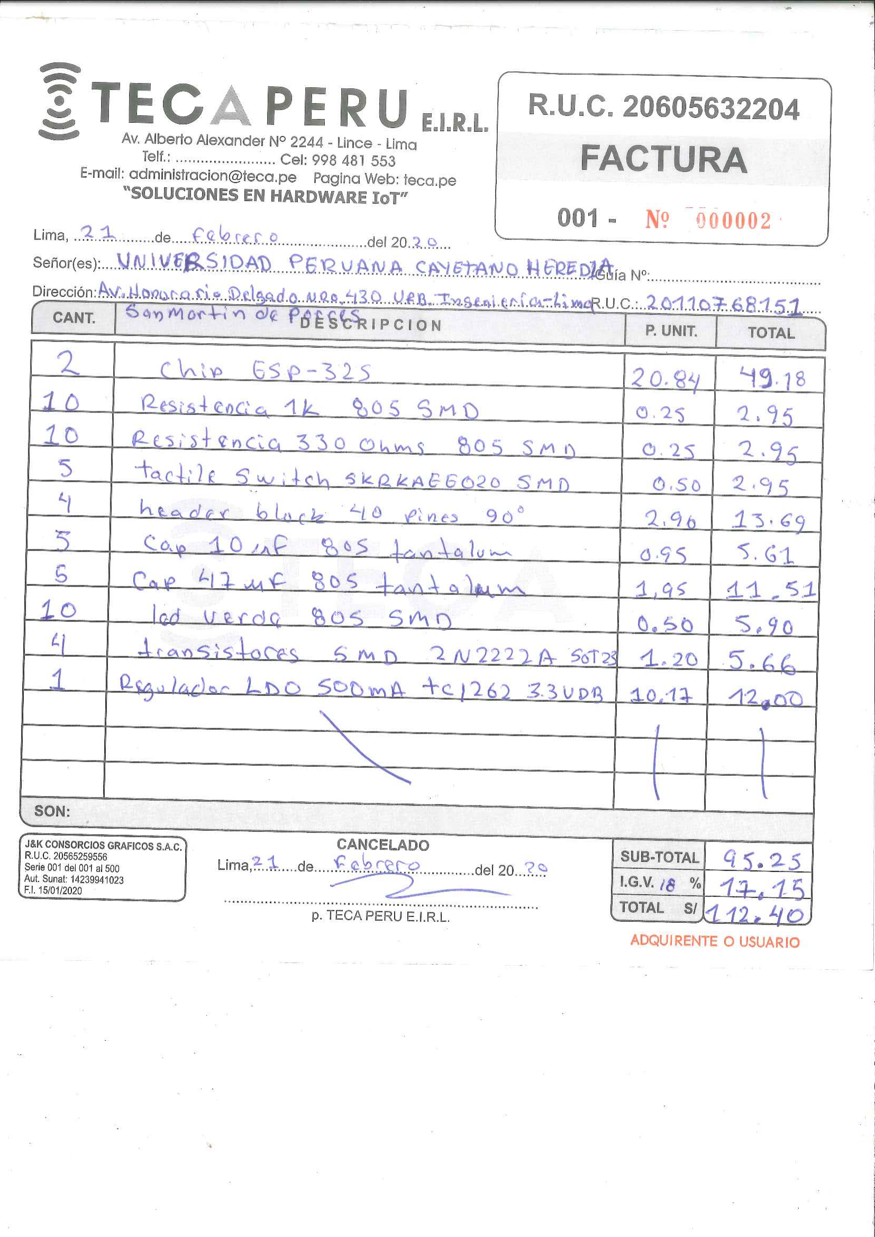
[picture p69: page 1]
