moisesStevend/Health-Recover/DESARROLLO TECNOLOGICO/PCB/HR/fotos/1403164940148698746.jpg

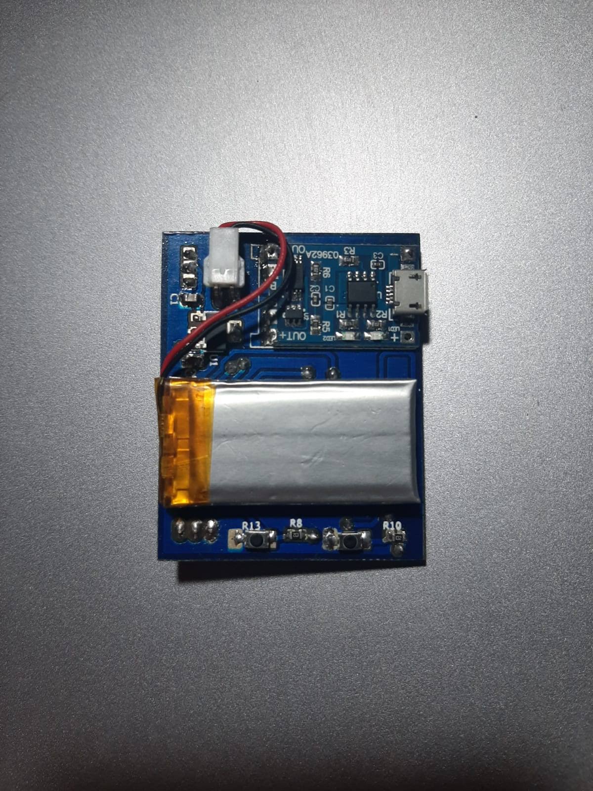
DESARROLLO TECNOLOGICO/PCB/HR/fotos/1403164940148698746.jpg
