moisesStevend/Health-Recover/DESARROLLO TECNOLOGICO/PCB/HR/fotos/2417265225157295465.jpg

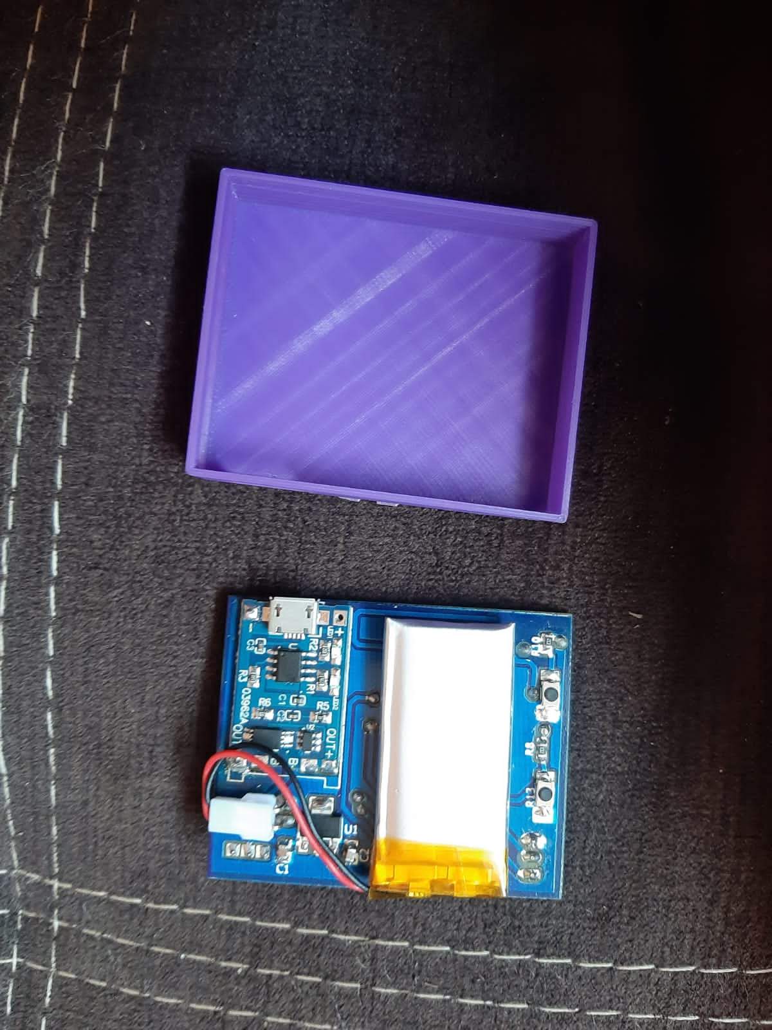
DESARROLLO TECNOLOGICO/PCB/HR/fotos/2417265225157295465.jpg
