moisesStevend/Health-Recover/DESARROLLO TECNOLOGICO/PCB/HR/fotos/8848443237596802152.jpg

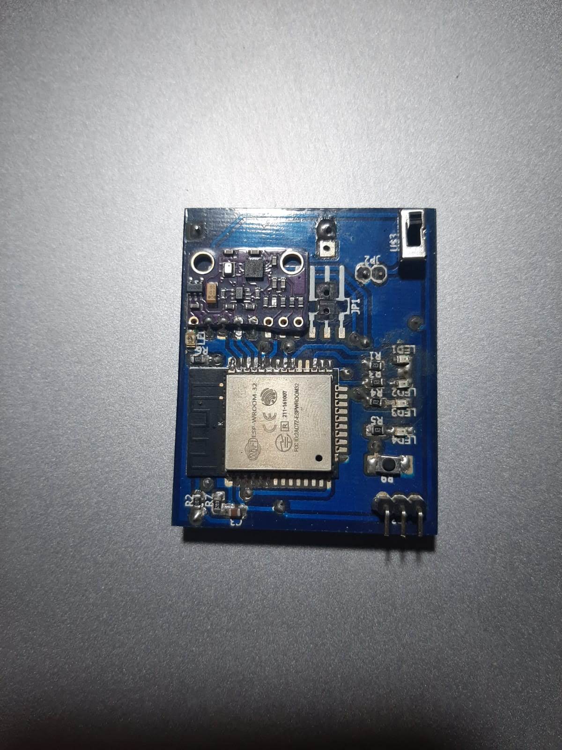
DESARROLLO TECNOLOGICO/PCB/HR/fotos/8848443237596802152.jpg
