moisesStevend/Health-Recover/DESARROLLO TECNOLOGICO/PCB/HR/fotos/Selection_265.png

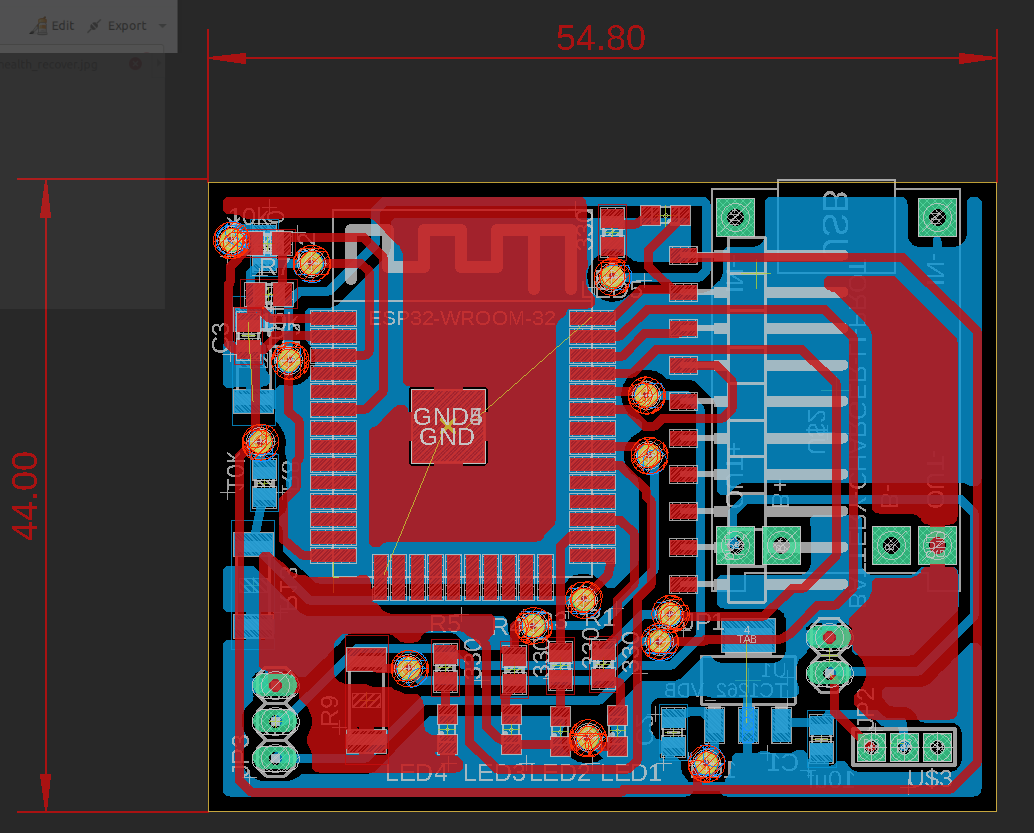
DESARROLLO TECNOLOGICO/PCB/HR/fotos/Selection_265.png
