moisesStevend/Health-Recover/DESARROLLO TECNOLOGICO/PCB/HR/fotos/Selection_266.png

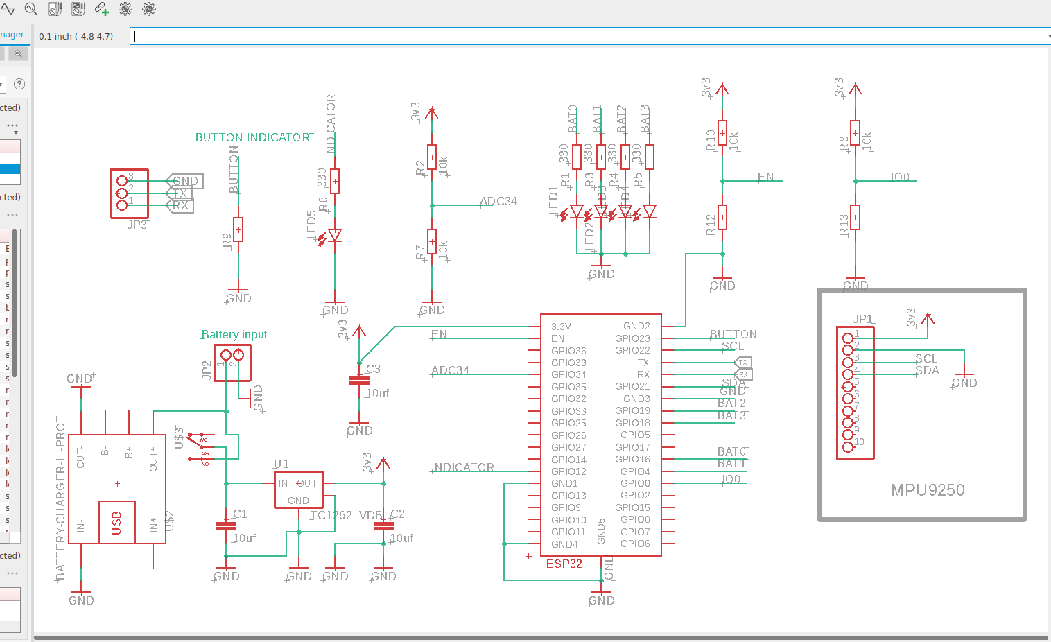
DESARROLLO TECNOLOGICO/PCB/HR/fotos/Selection_266.png
