moisesStevend/Health-Recover/DESARROLLO TECNOLOGICO/PCB/HR/fotos/Selection_267.png

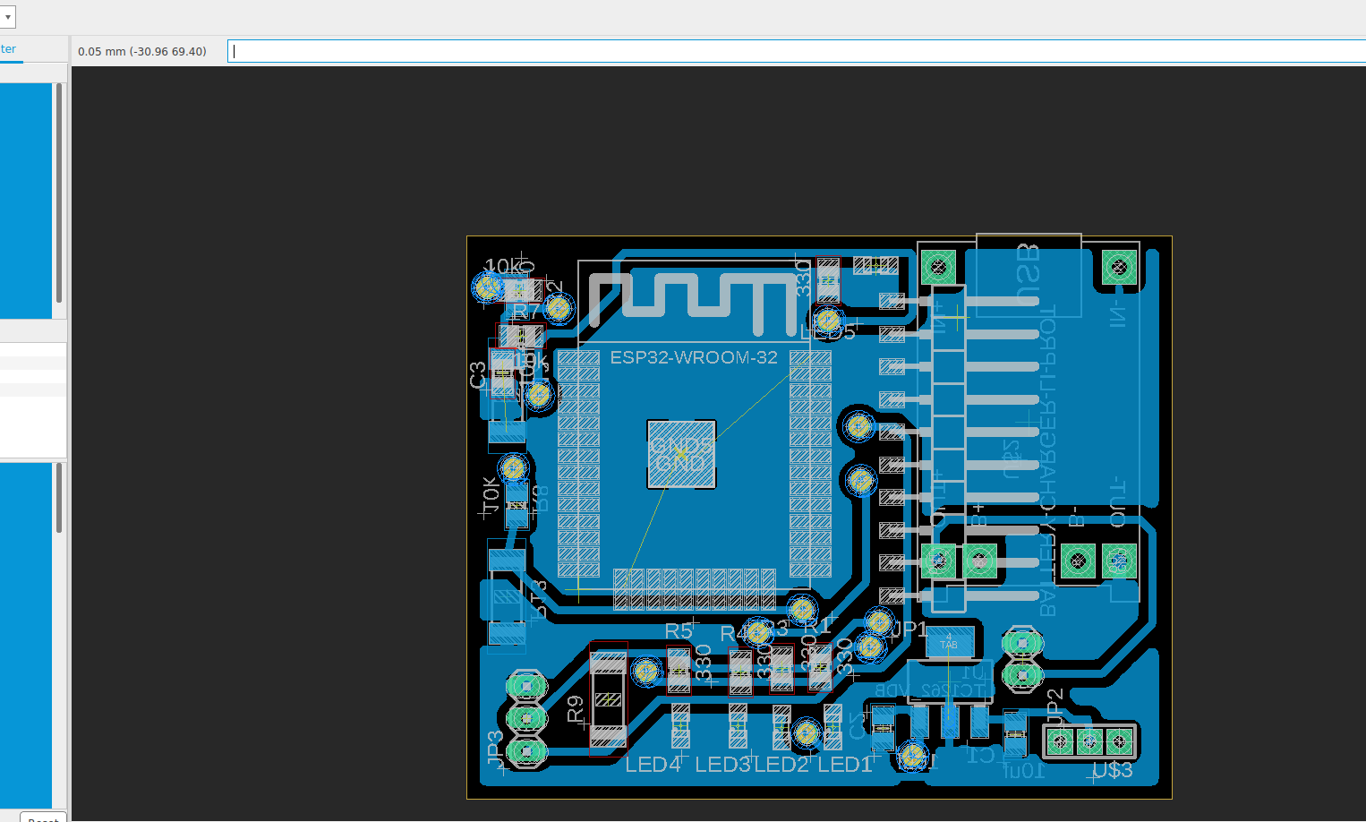
DESARROLLO TECNOLOGICO/PCB/HR/fotos/Selection_267.png
