moisesStevend/Health-Recover/EVIDENCIAS/fotos/GIF animados/conectar.gif

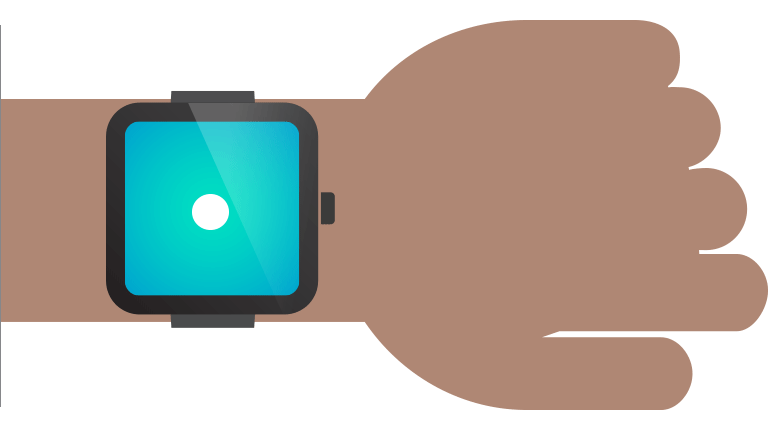
EVIDENCIAS/fotos/GIF animados/conectar.gif
