moisesStevend/Health-Recover/EVIDENCIAS/fotos/GIF animados/fin.gif

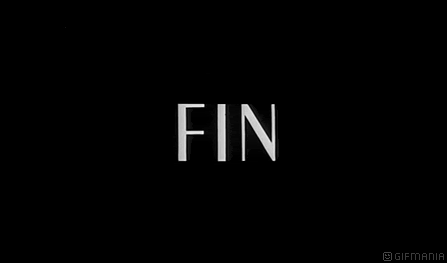
EVIDENCIAS/fotos/GIF animados/fin.gif
