moisesStevend/Health-Recover/EVIDENCIAS/fotos/GIF animados/iniciar.gif

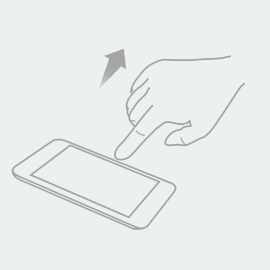
EVIDENCIAS/fotos/GIF animados/iniciar.gif
