moisesStevend/Health-Recover/EVIDENCIAS/fotos/GIF animados/move01.gif

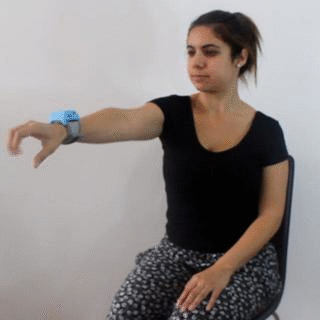
EVIDENCIAS/fotos/GIF animados/move01.gif
