moisesStevend/Health-Recover/EVIDENCIAS/fotos/GIF animados/move02.gif

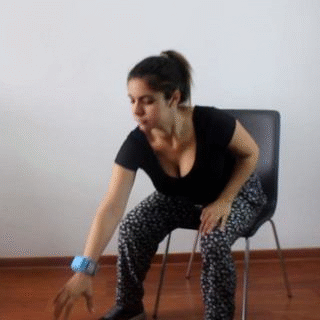
EVIDENCIAS/fotos/GIF animados/move02.gif
