moisesStevend/Health-Recover/EVIDENCIAS/fotos/GIF animados/move03.gif

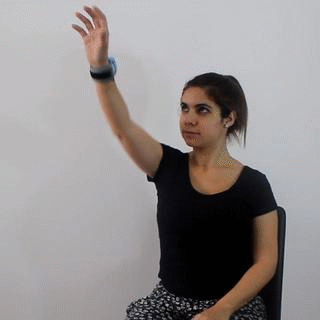
EVIDENCIAS/fotos/GIF animados/move03.gif
