moisesStevend/Health-Recover/EVIDENCIAS/fotos/GIF animados/move04.gif

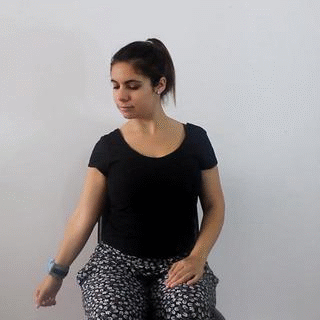
EVIDENCIAS/fotos/GIF animados/move04.gif
