moisesStevend/Health-Recover/EVIDENCIAS/fotos/GIF animados/move05.gif

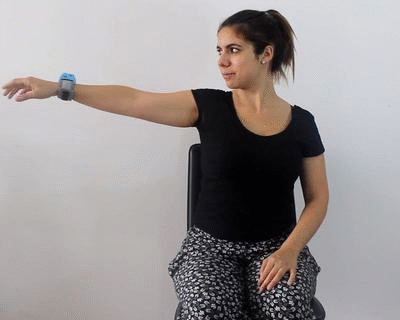
EVIDENCIAS/fotos/GIF animados/move05.gif
