moisesStevend/Health-Recover/EVIDENCIAS/fotos/GIF animados/move06.gif

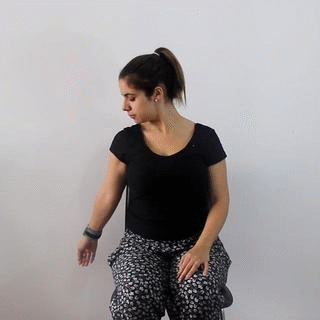
EVIDENCIAS/fotos/GIF animados/move06.gif
