moisesStevend/Health-Recover/EVIDENCIAS/fotos/GIF animados/move07.gif

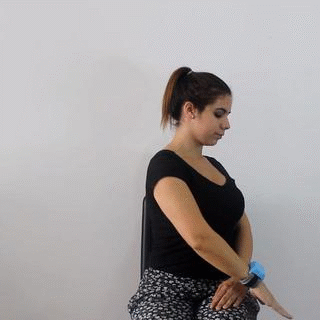
EVIDENCIAS/fotos/GIF animados/move07.gif
