moisesStevend/Health-Recover/EVIDENCIAS/fotos/GIF animados/move08.gif

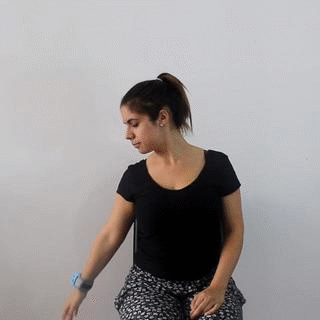
EVIDENCIAS/fotos/GIF animados/move08.gif
