moisesStevend/Health-Recover/EVIDENCIAS/fotos/GIF animados/move09.gif

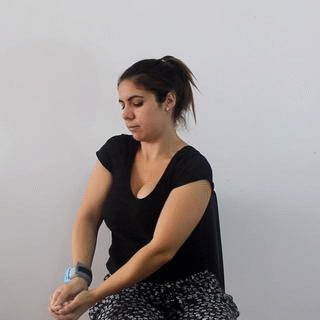
EVIDENCIAS/fotos/GIF animados/move09.gif
