moisesStevend/Health-Recover/EVIDENCIAS/fotos/health_recover.jpg

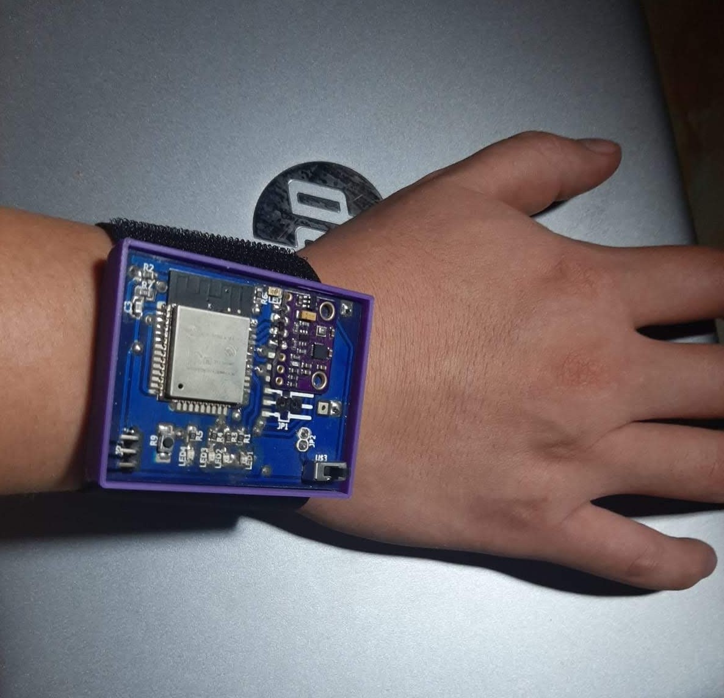
EVIDENCIAS/fotos/health_recover.jpg
