moisesStevend/Health-Recover/EVIDENCIAS/fotos/HR_fotos/2020-02-19.jpg

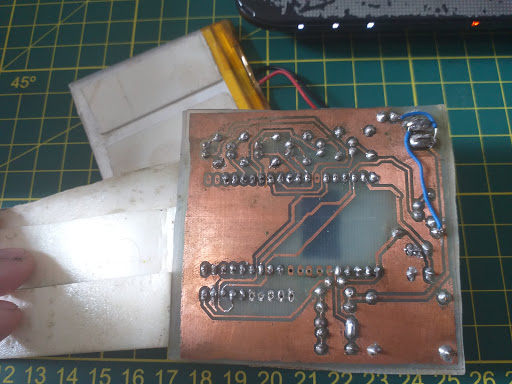
EVIDENCIAS/fotos/HR_fotos/2020-02-19.jpg
