moisesStevend/Health-Recover/EVIDENCIAS/fotos/HR_fotos/1605155813119465375.jpg

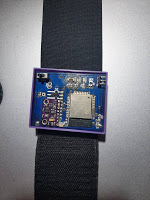
EVIDENCIAS/fotos/HR_fotos/1605155813119465375.jpg
