moisesStevend/Health-Recover/EVIDENCIAS/fotos/HR_fotos/4151480943440290598.jpg

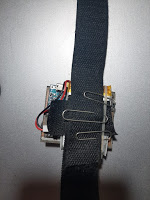
EVIDENCIAS/fotos/HR_fotos/4151480943440290598.jpg
