moisesStevend/Health-Recover/EVIDENCIAS/fotos/HR_fotos/5037421753506465000.jpg

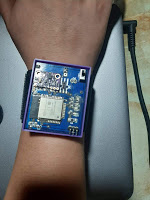
EVIDENCIAS/fotos/HR_fotos/5037421753506465000.jpg
