moisesStevend/Health-Recover/EVIDENCIAS/fotos/HR_fotos/5852126763270116735.jpg

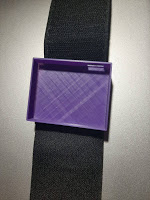
EVIDENCIAS/fotos/HR_fotos/5852126763270116735.jpg
