moisesStevend/Health-Recover/EVIDENCIAS/fotos/HR_fotos/5991876001669918382.jpg

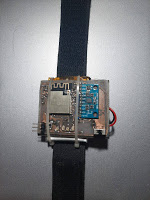
EVIDENCIAS/fotos/HR_fotos/5991876001669918382.jpg
