moisesStevend/Health-Recover/EVIDENCIAS/fotos/HR_fotos/8657059707876414303.jpg

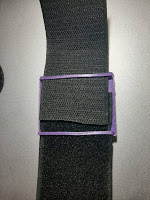
EVIDENCIAS/fotos/HR_fotos/8657059707876414303.jpg
