moisesStevend/Health-Recover/EVIDENCIAS/fotos/HR_fotos/schematic.png

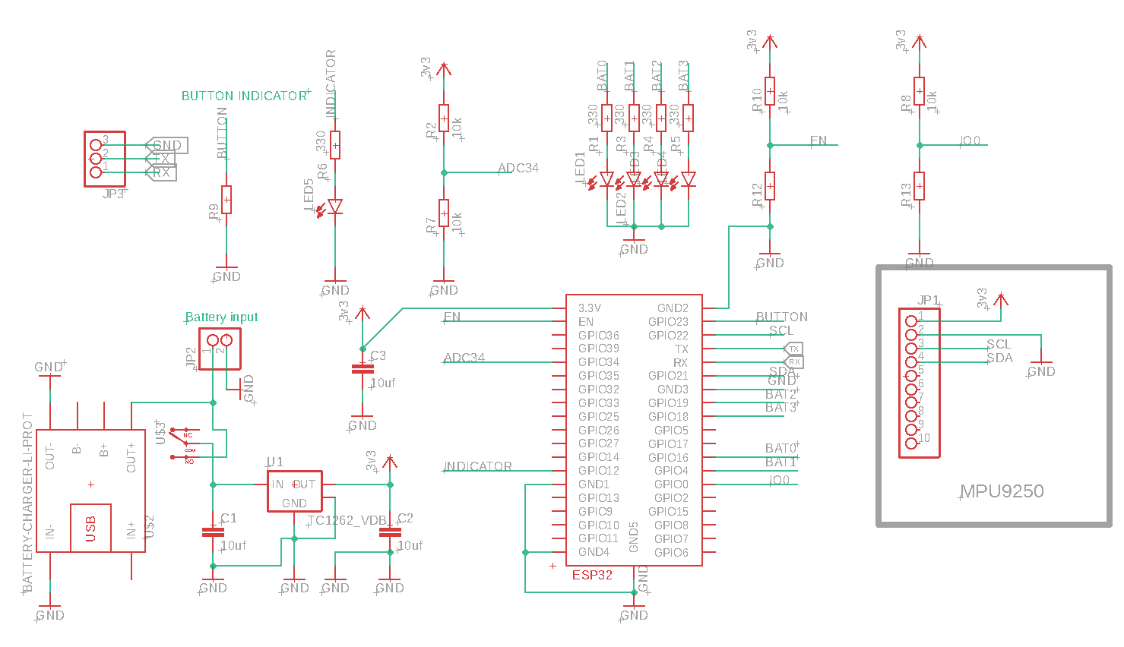
EVIDENCIAS/fotos/HR_fotos/schematic.png
