moisesStevend/Health-Recover/LOGISTICA/compras/lote pequeño 5 unidades/WhatsApp Image 2020-05-21 at 18.43.13.jpeg

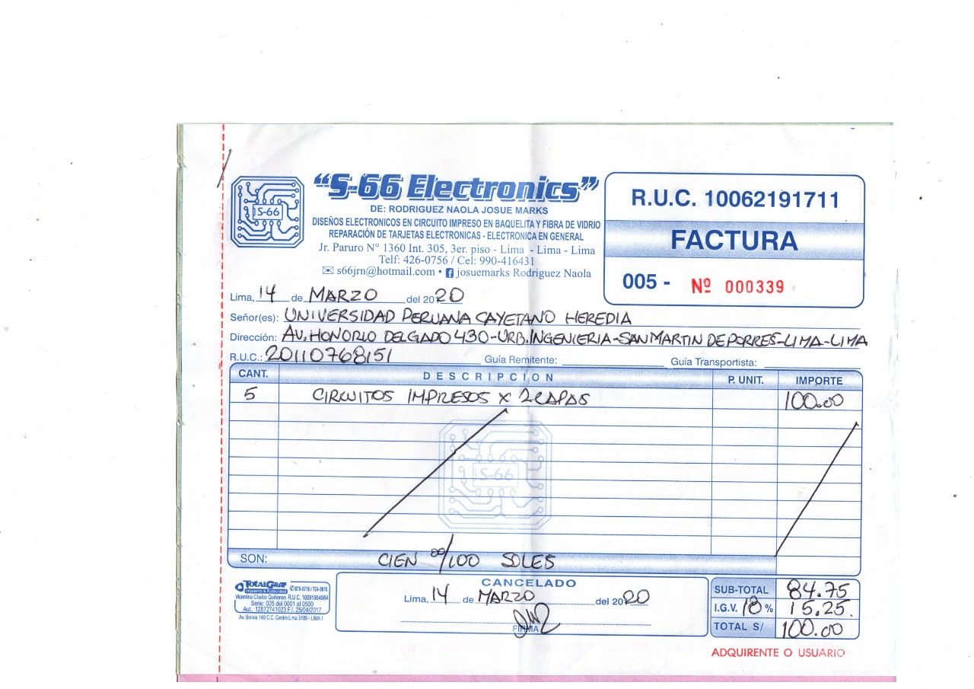
LOGISTICA/compras/lote pequeño 5 unidades/WhatsApp Image 2020-05-21 at 18.43.13.jpeg
