moisesStevend/Health-Recover/DESARROLLO TECNOLOGICO/diseño 3D/HR_v2/diseños FreeCad/HR_v2.FCStd

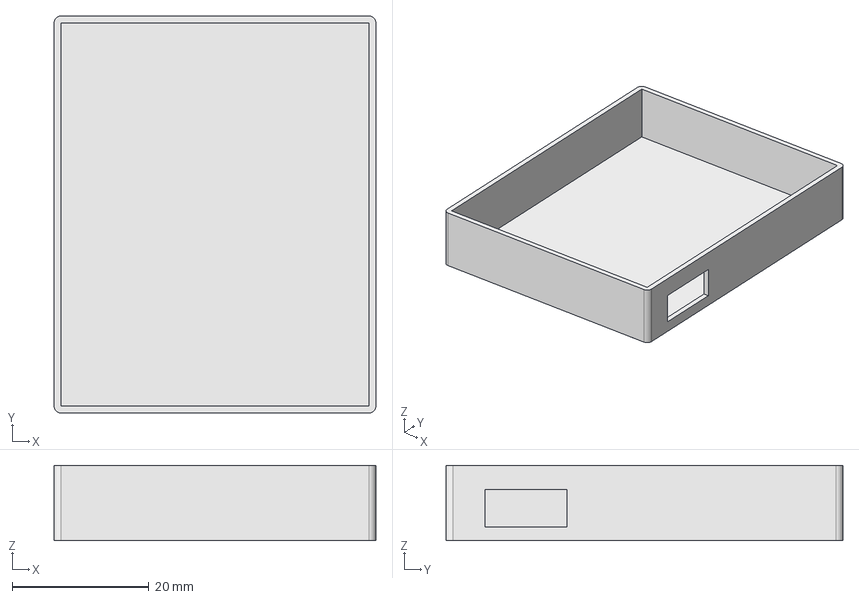
[picture p107: CAD file, 2020-06-16]
DESARROLLO TECNOLOGICO/diseño 3D/HR_v2/diseños FreeCad/HR_v2.FCStd
47.0 x 58.0 x 11.0 mm
