moisesStevend/Health-Recover/DESARROLLO TECNOLOGICO/diseño 3D/HR_v2/STL/parte_inferior.stl

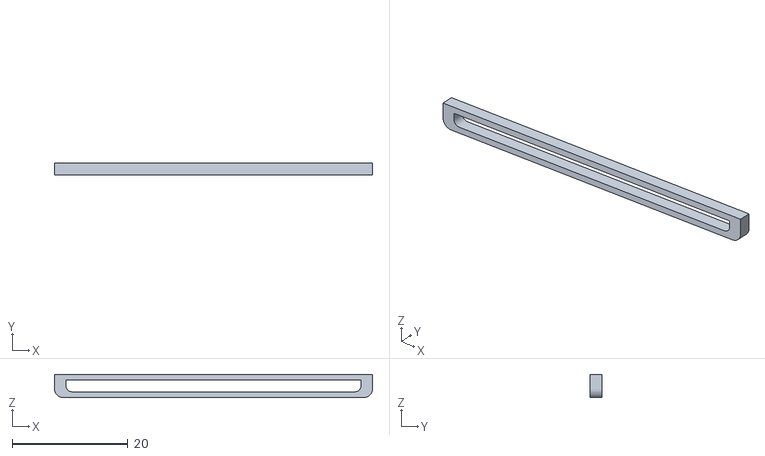
[picture p108: CAD file, 2020-06-24]
DESARROLLO TECNOLOGICO/diseño 3D/HR_v2/STL/parte_inferior.stl
55.0 x 2.00 x 4.00
