moisesStevend/Health-Recover/(list of files, cad)

Other CAD files:
DESARROLLO TECNOLOGICO/diseño 3D/HR_v2/diseños FreeCad/HR_v2_parte_inferior.FCStd
