moisesStevend/Health-Recover/DESARROLLO TECNOLOGICO/PCB/HR/version2_2.pdf

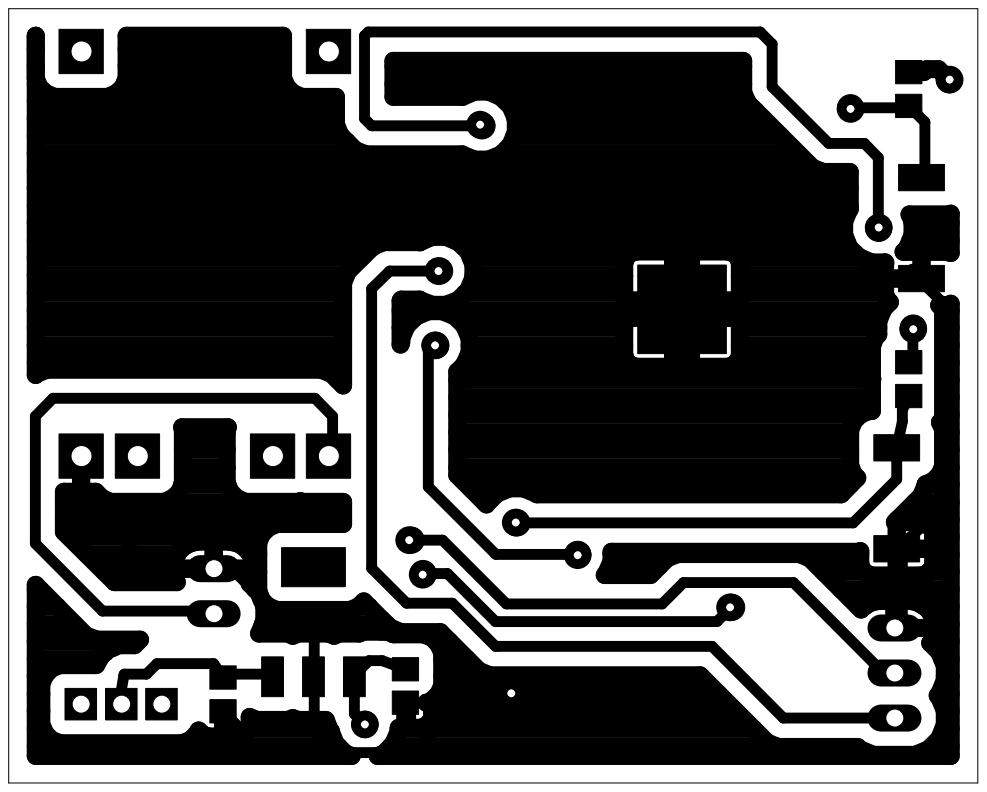
[picture p109: page 1]
