moisesStevend/Health-Recover/DESARROLLO TECNOLOGICO/PCB/HR/version_small_2_bottom.pdf

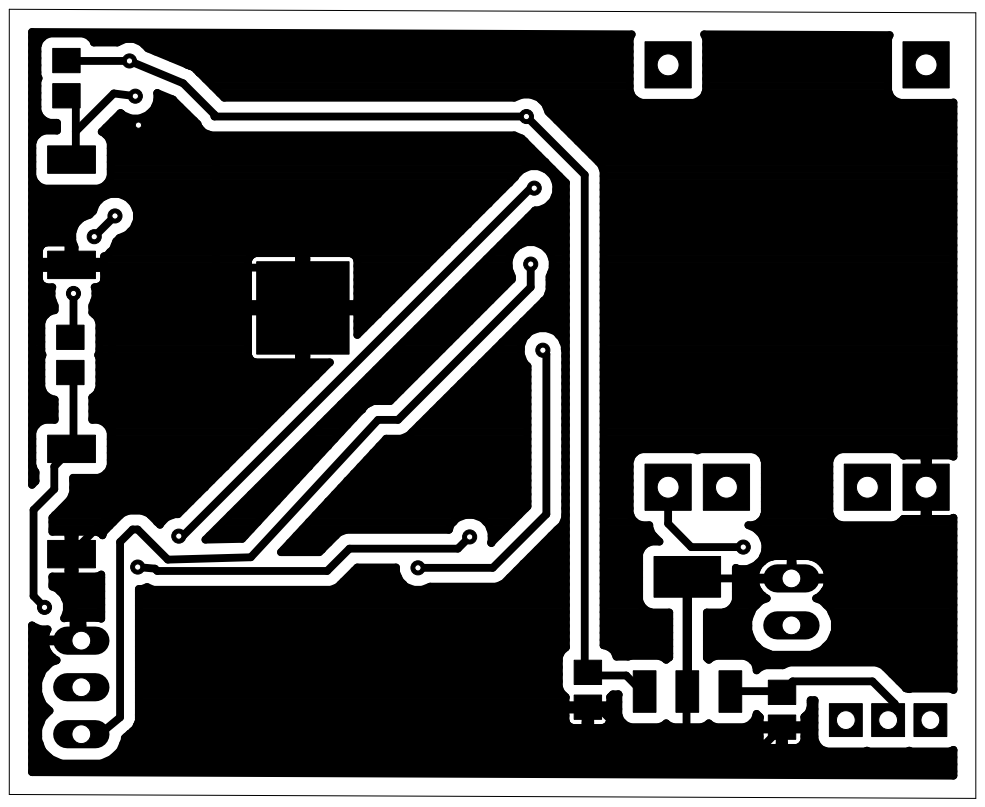
[picture p110: page 1]
