moisesStevend/Health-Recover/DESARROLLO TECNOLOGICO/PCB/HR/version_small_2_top.pdf

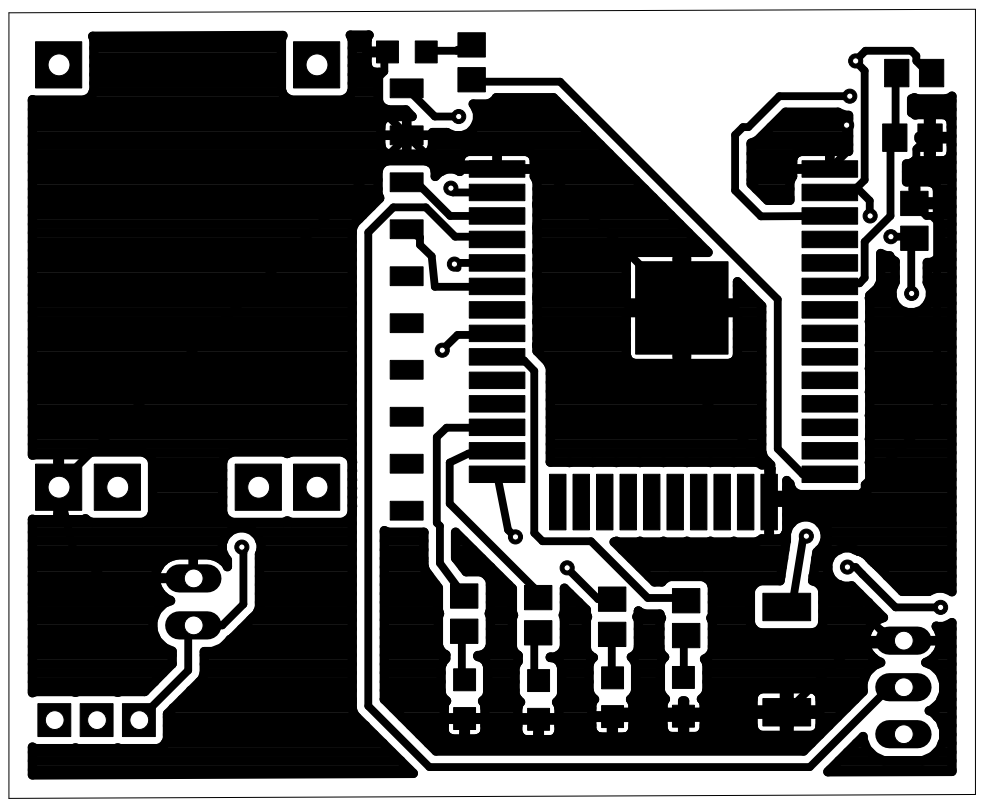
[picture p111: page 1]
