moisesStevend/Health-Recover/_old_HR/PCB_HW_2017/UPCH_sch.pdf

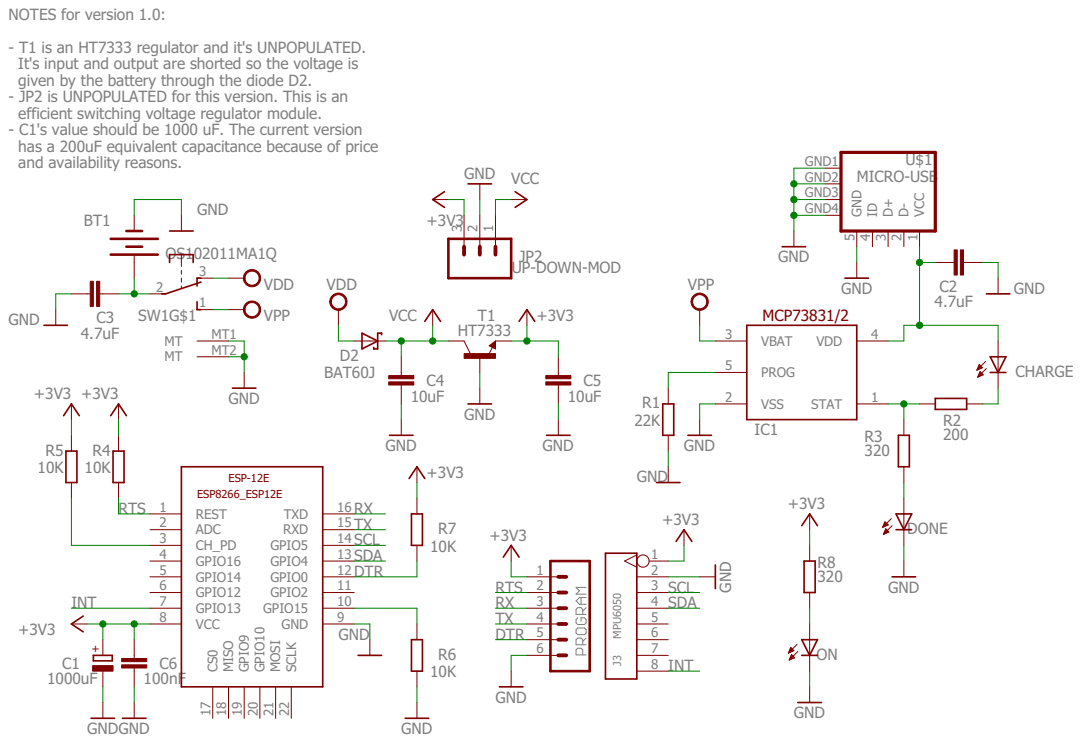
[picture p112: page 1]

NOTES for version 1.0: - T1 is an HT7333 regulator and it's UNPOPULATED. It's input and output are shorted so the voltage is

given by the battery through the diode D2. - JP2 is UNPOPULATED for this version. This is an

efficient switching voltage regulator module. - C1's value should be 1000 uF. The current version

has a 200uF equivalent capacitance because of price
and availability reasons.
