moisesStevend/Health-Recover/_old_HR/PCB_HW_2017/UPCH_bottom.pdf

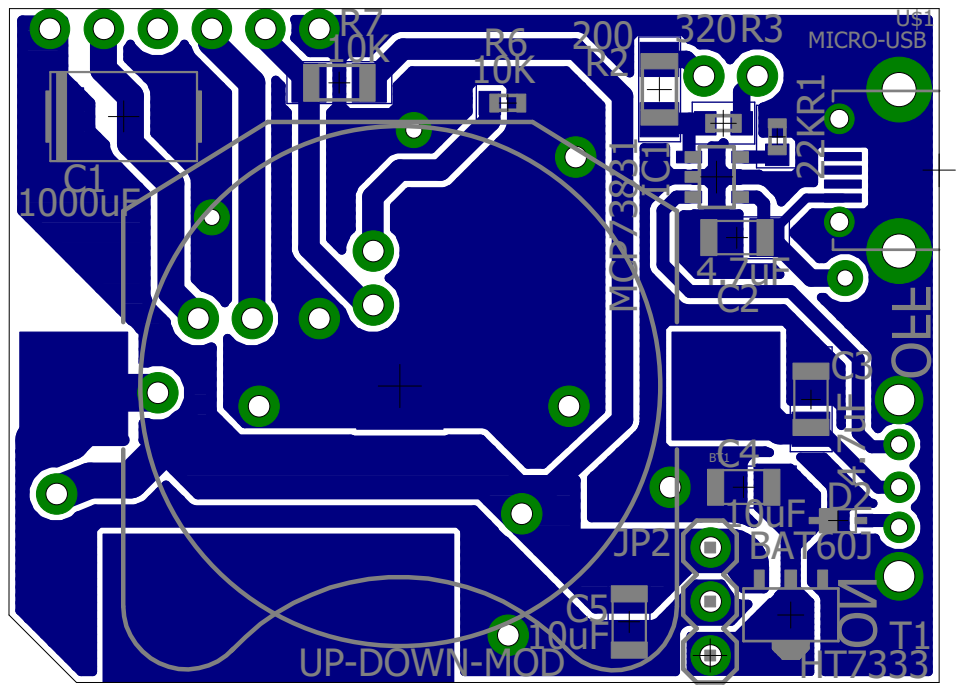
[picture p113: page 1]

ON OFF C1 C2 C3 C4 C5 JP2 T1 IC1 R1R2 R3 R6 R7 BT1 U$1 D2 1000uF 4.7uF 4.7uF 10uF 10uF UP-DOWN-MOD HT7333 MCP7383122K 200 320 10K 10K MICRO-USB BAT60J
