moisesStevend/Health-Recover/_old_HR/PCB_HW_2017/UPCH_top.pdf

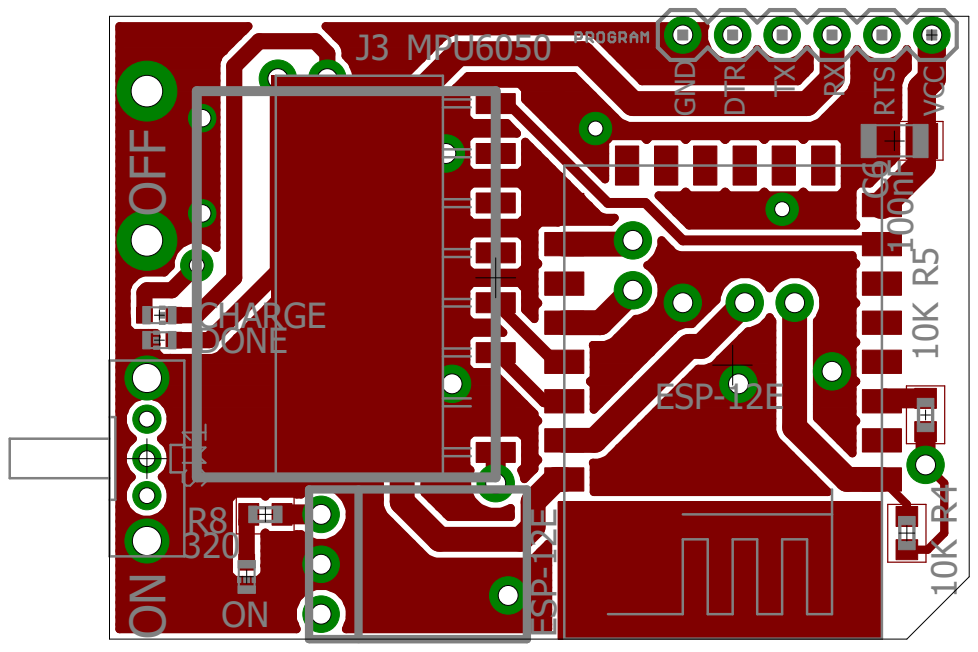
[picture p114: page 1]
