moisesStevend/Health-Recover/DESARROLLO TECNOLOGICO/PCB/HR/version1.pdf

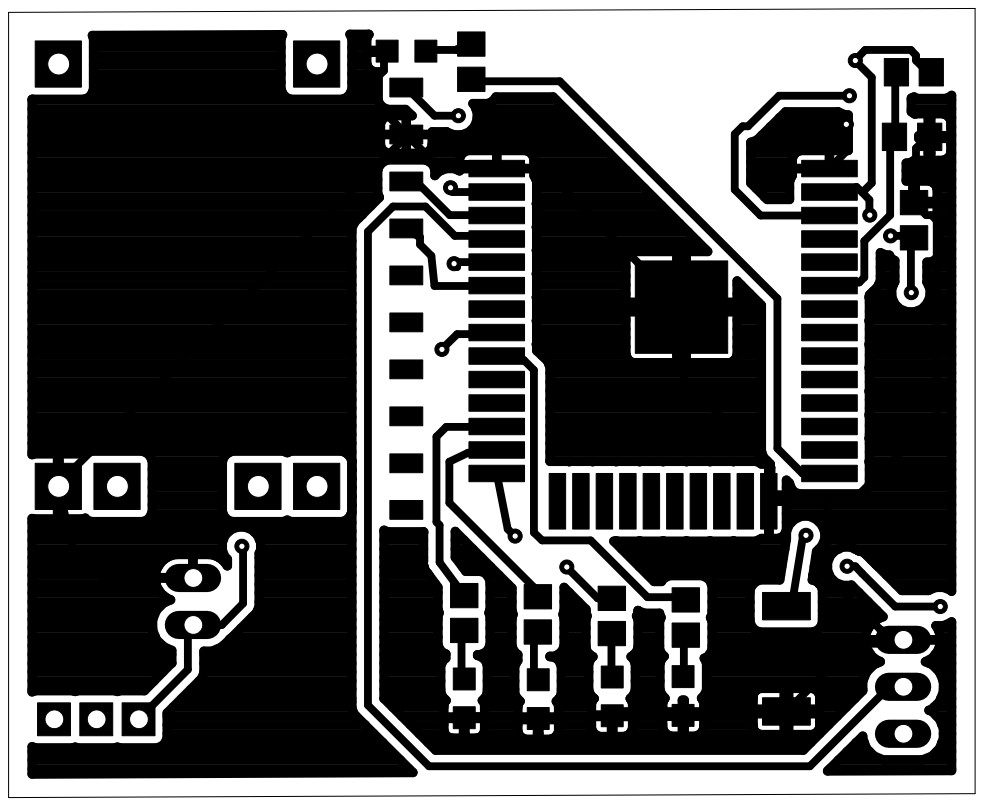
[picture p115: page 1]
