moisesStevend/Health-Recover/DESARROLLO TECNOLOGICO/PCB/_old_HR3/version_small_2_top.pdf

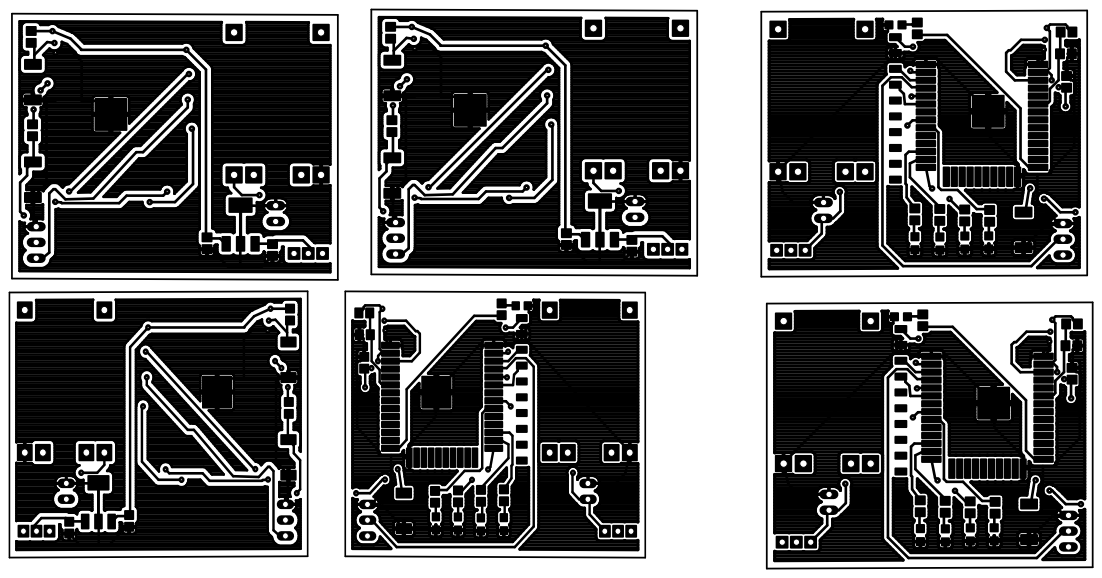
[picture p116: page 1]
