moisesStevend/Health-Recover/DESARROLLO TECNOLOGICO/PCB/_old_HR_2/esp32_hr_module2.pdf

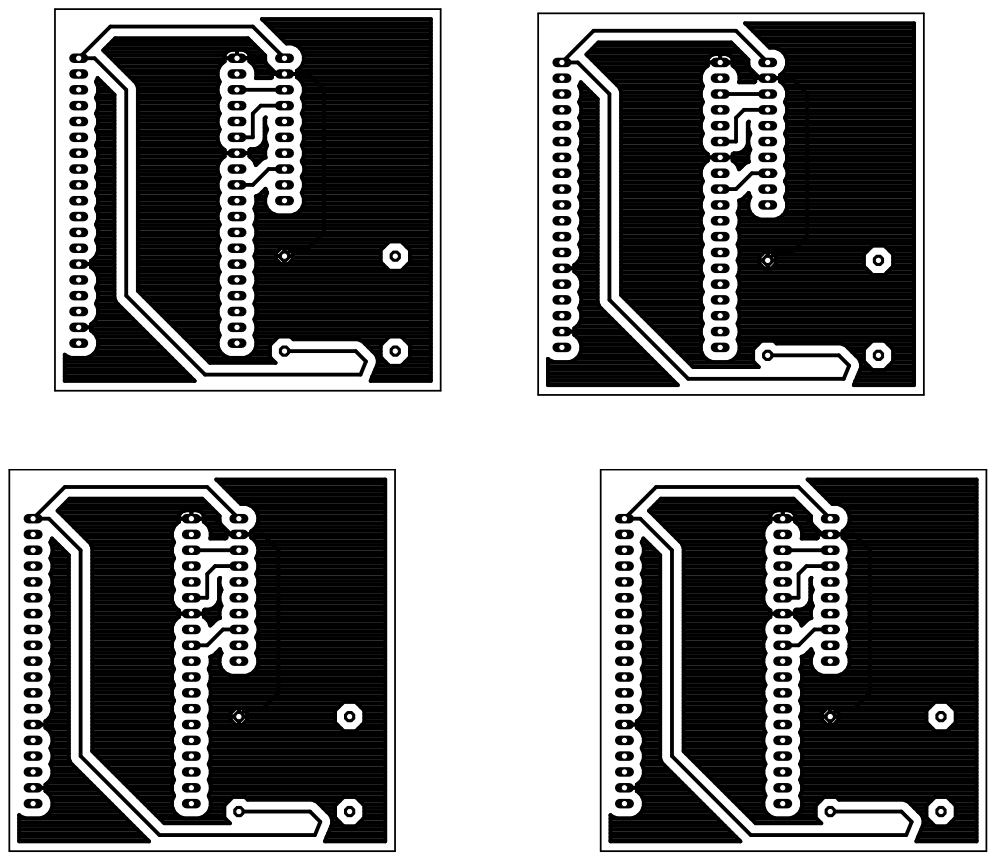
[picture p117: page 1]
