moisesStevend/Health-Recover/DESARROLLO TECNOLOGICO/PCB/_old_HR_2/esp32_hr_module3.pdf

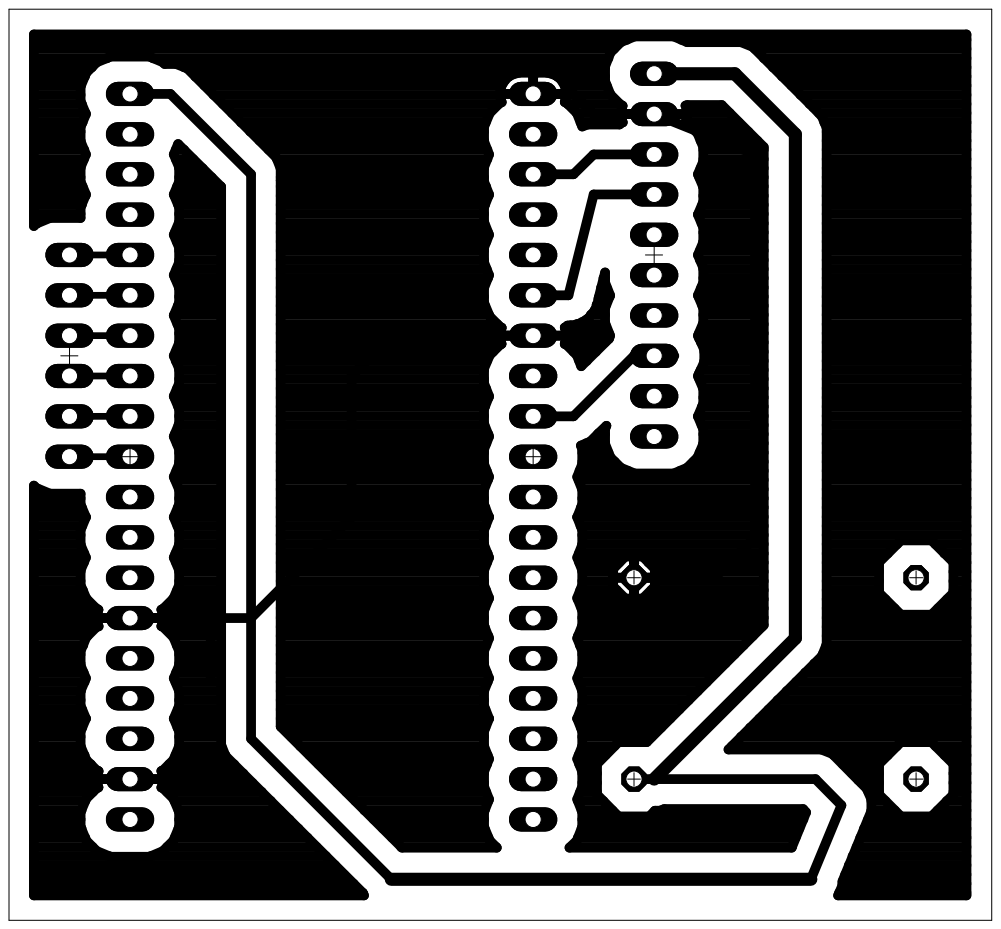
[picture p118: page 1]
