moisesStevend/Health-Recover/DESARROLLO TECNOLOGICO/PCB/_old_HR_2/esp32_hr_module_final.pdf

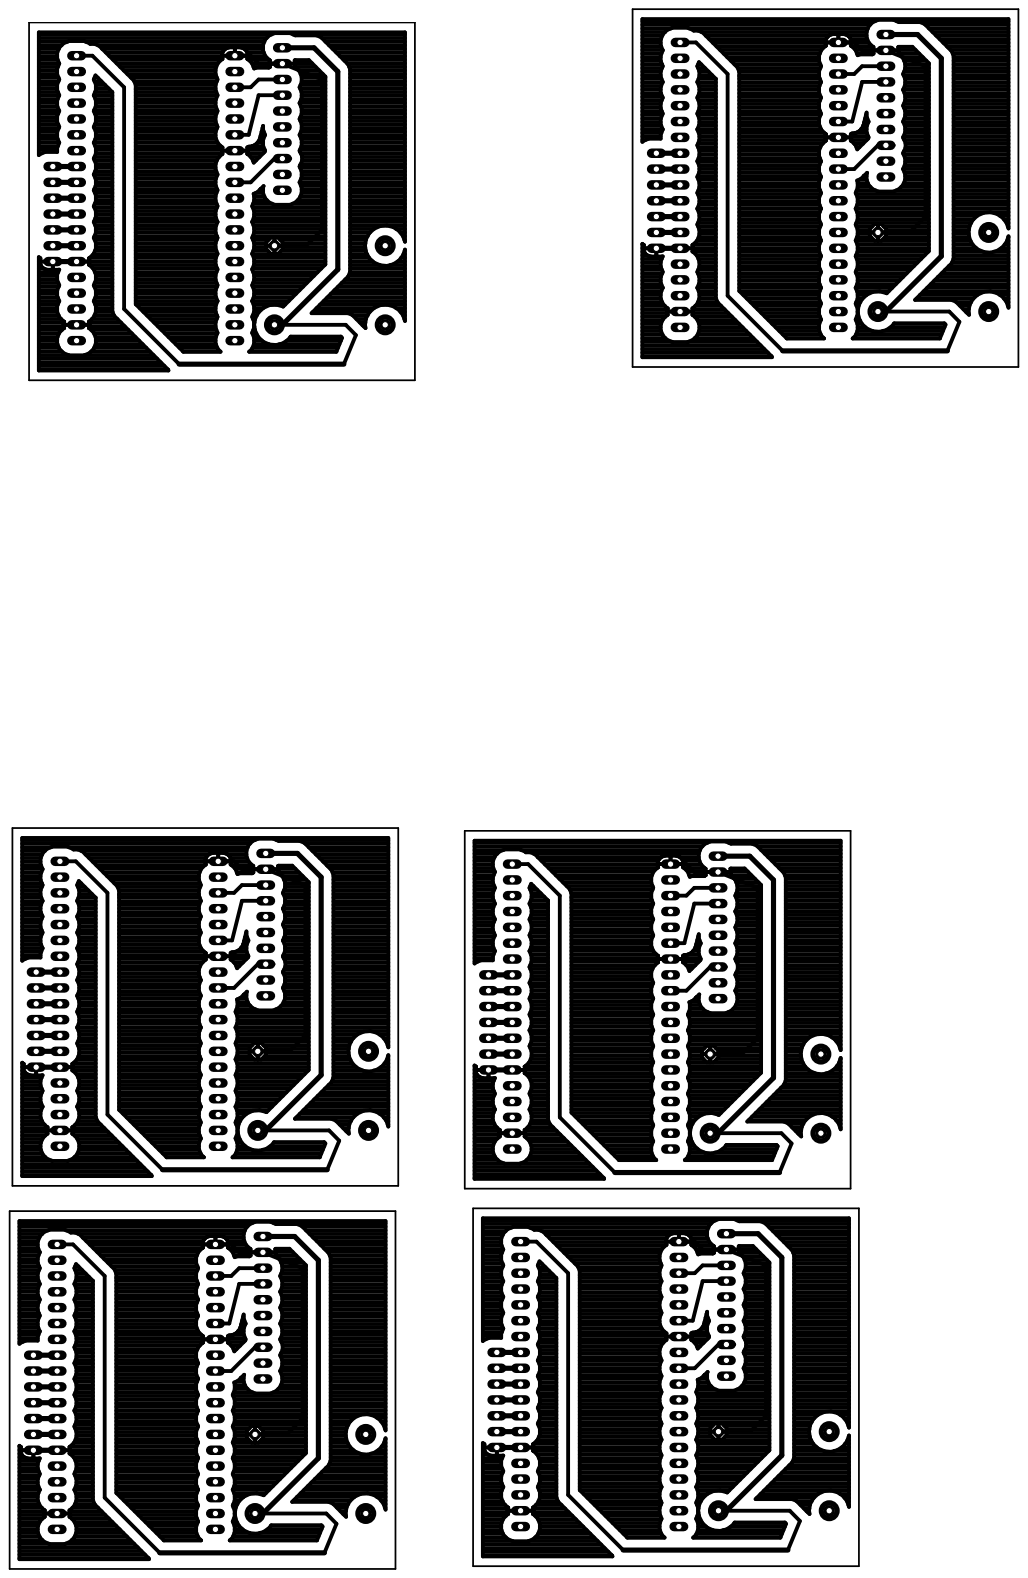
[picture p119: page 1]
