moisesStevend/Health-Recover/DESARROLLO TECNOLOGICO/PCB/_old_HR_2/modulev2.pdf

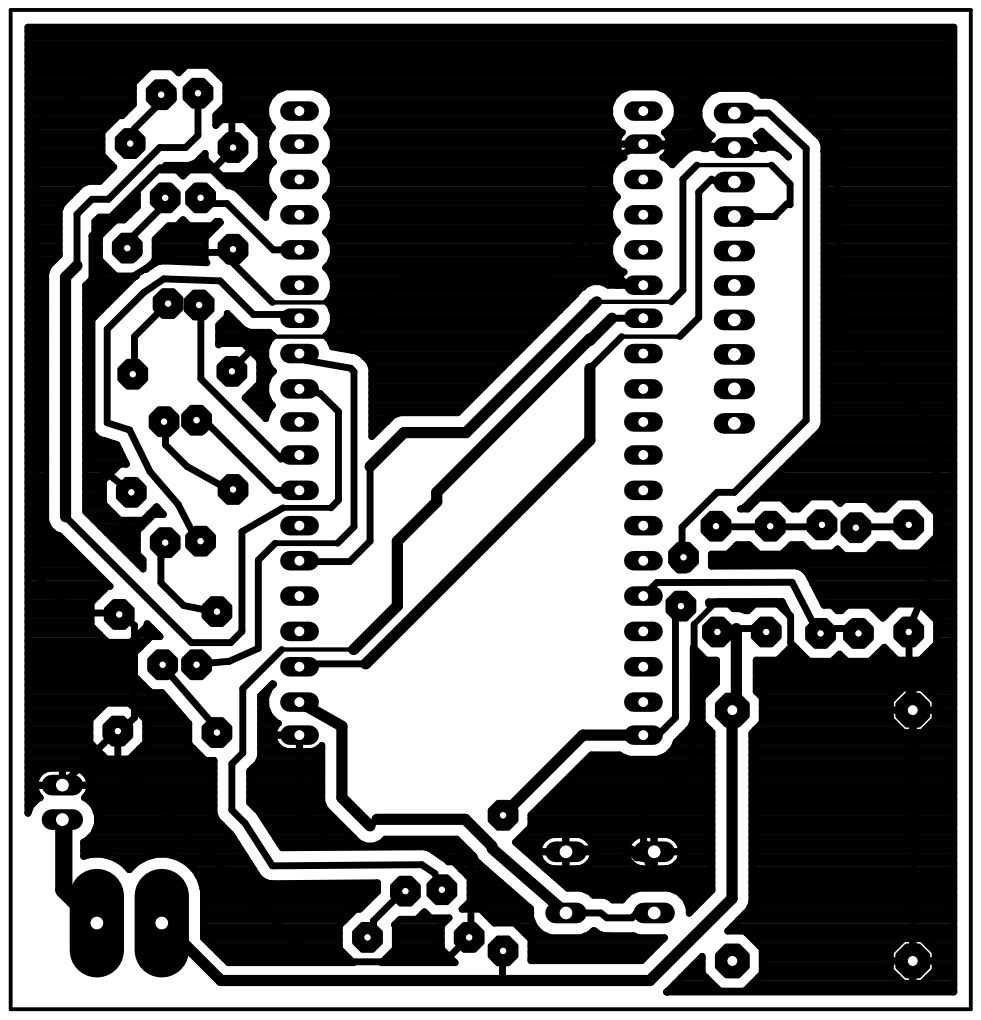
[picture p120: page 1]
