moisesStevend/Health-Recover/DESARROLLO TECNOLOGICO/PCB/_old_HR_2/modulev2_TOP.pdf

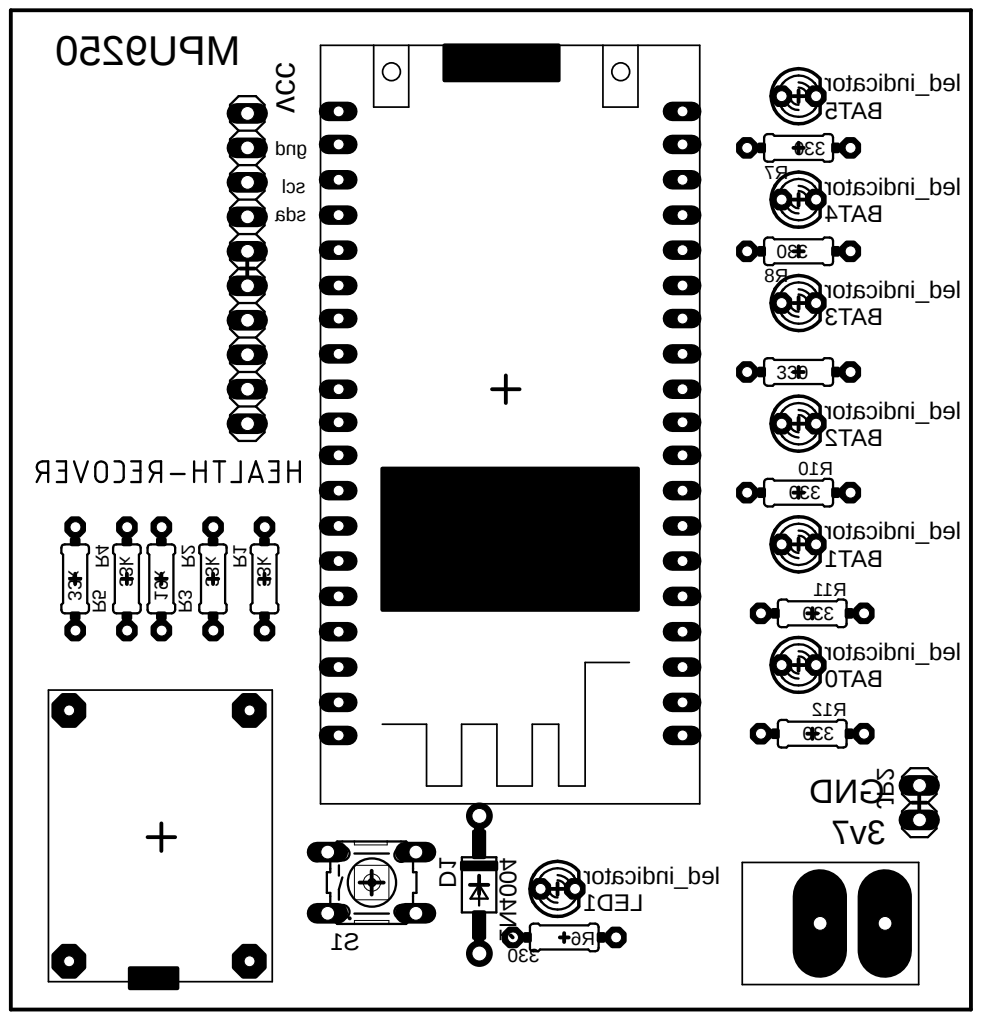
[picture p121: page 1]
