moisesStevend/Health-Recover/DESARROLLO TECNOLOGICO/PCB/HR/version2_1.pdf

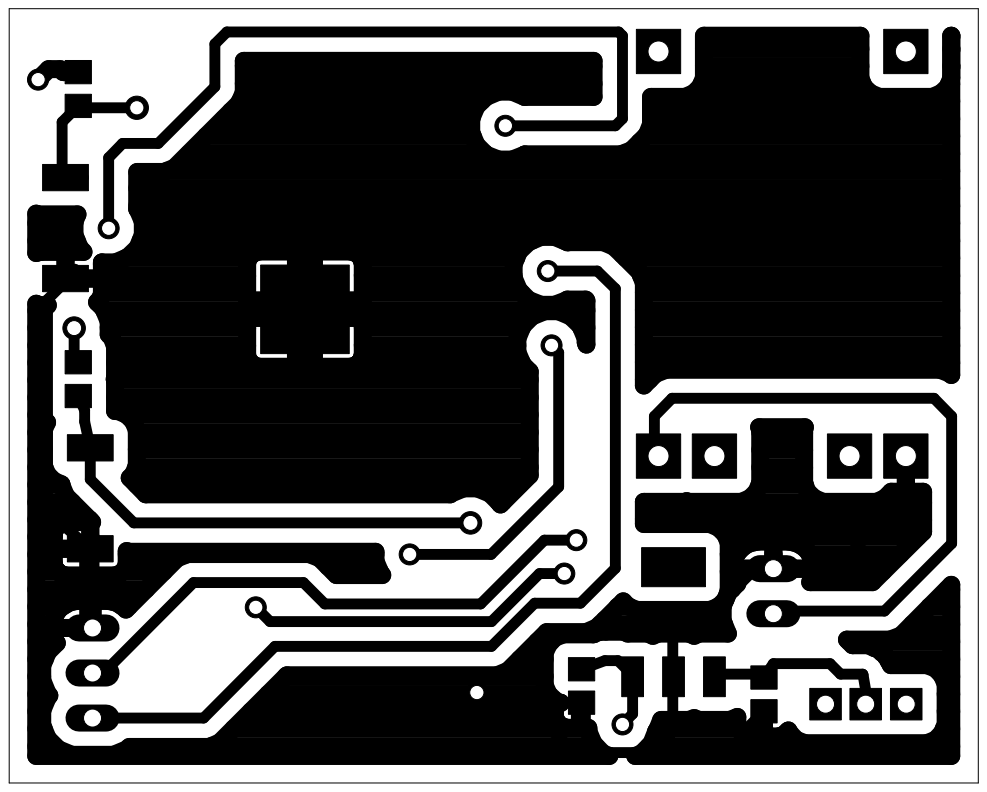
[picture p122: page 1]
