moisesStevend/Health-Recover/DESARROLLO TECNOLOGICO/PCB/_old_HR_2/esp32_hr_module.brd

## EAGLE design DESARROLLO TECNOLOGICO/PCB/_old_HR_2/esp32_hr_module.brd (2020-05-18, an earlier design)

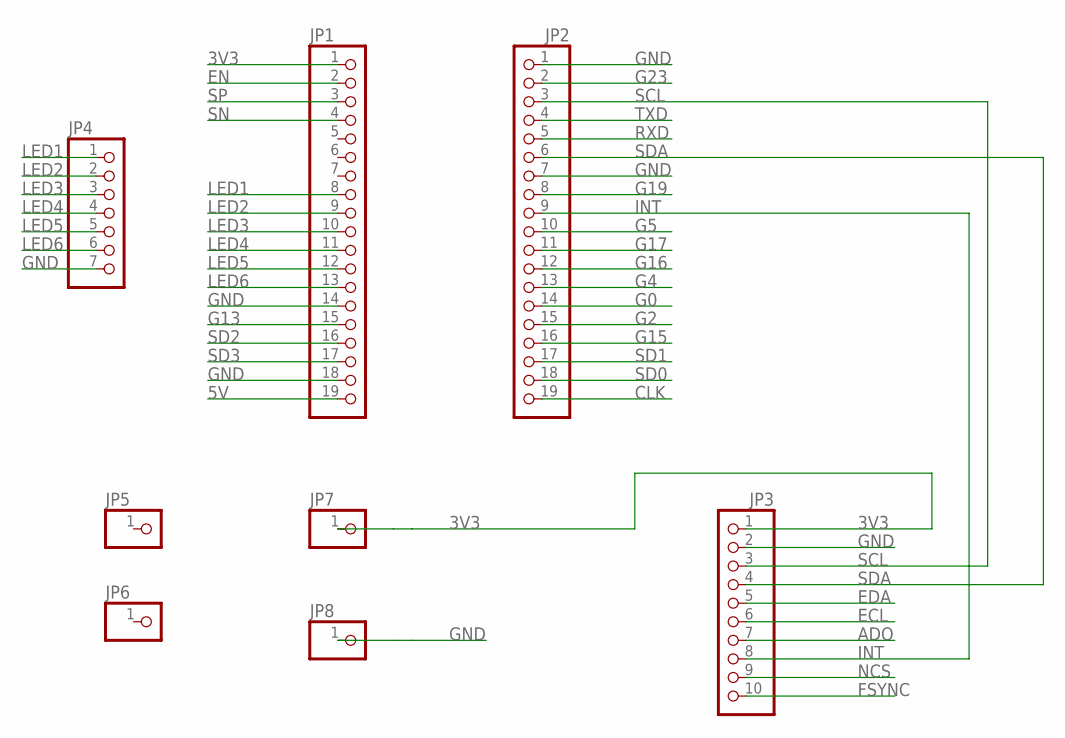
[picture p123: schematic esp32_hr_module.sch]

Parts:
JP1, JP2: PINHD-1X19; 1X19
JP3: PINHD-1X10; 1X10
JP4: PINHD-1X7; 1X07
JP5, JP6, JP7, JP8: PINHD-1X1; 1X01

Connections:
3V3: JP1.1, JP3.1, JP7.1
5V: JP1.19
ADO: JP3.7
CLK: JP2.19
ECL: JP3.6
EDA: JP3.5
EN: JP1.2
FSYNC: JP3.10
G0: JP2.14
G2: JP2.15
G4: JP2.13
G5: JP2.10
G13: JP1.15
G15: JP2.16
G16: JP2.12
G17: JP2.11
G19: JP2.8
G23: JP2.2
GND: JP1.14, JP1.18, JP2.1, JP2.7, JP3.2, JP4.7, JP8.1
INT: JP2.9, JP3.8
LED1: JP1.8, JP4.1
LED2: JP1.9, JP4.2
LED3: JP1.10, JP4.3
LED4: JP1.11, JP4.4
LED5: JP1.12, JP4.5
LED6: JP1.13, JP4.6
NCS: JP3.9
RXD: JP2.5
SCL: JP2.3, JP3.3
SD0: JP2.18
SD1: JP2.17
SD2: JP1.16
SD3: JP1.17
SDA: JP2.6, JP3.4
SN: JP1.4
SP: JP1.3
TXD: JP2.4

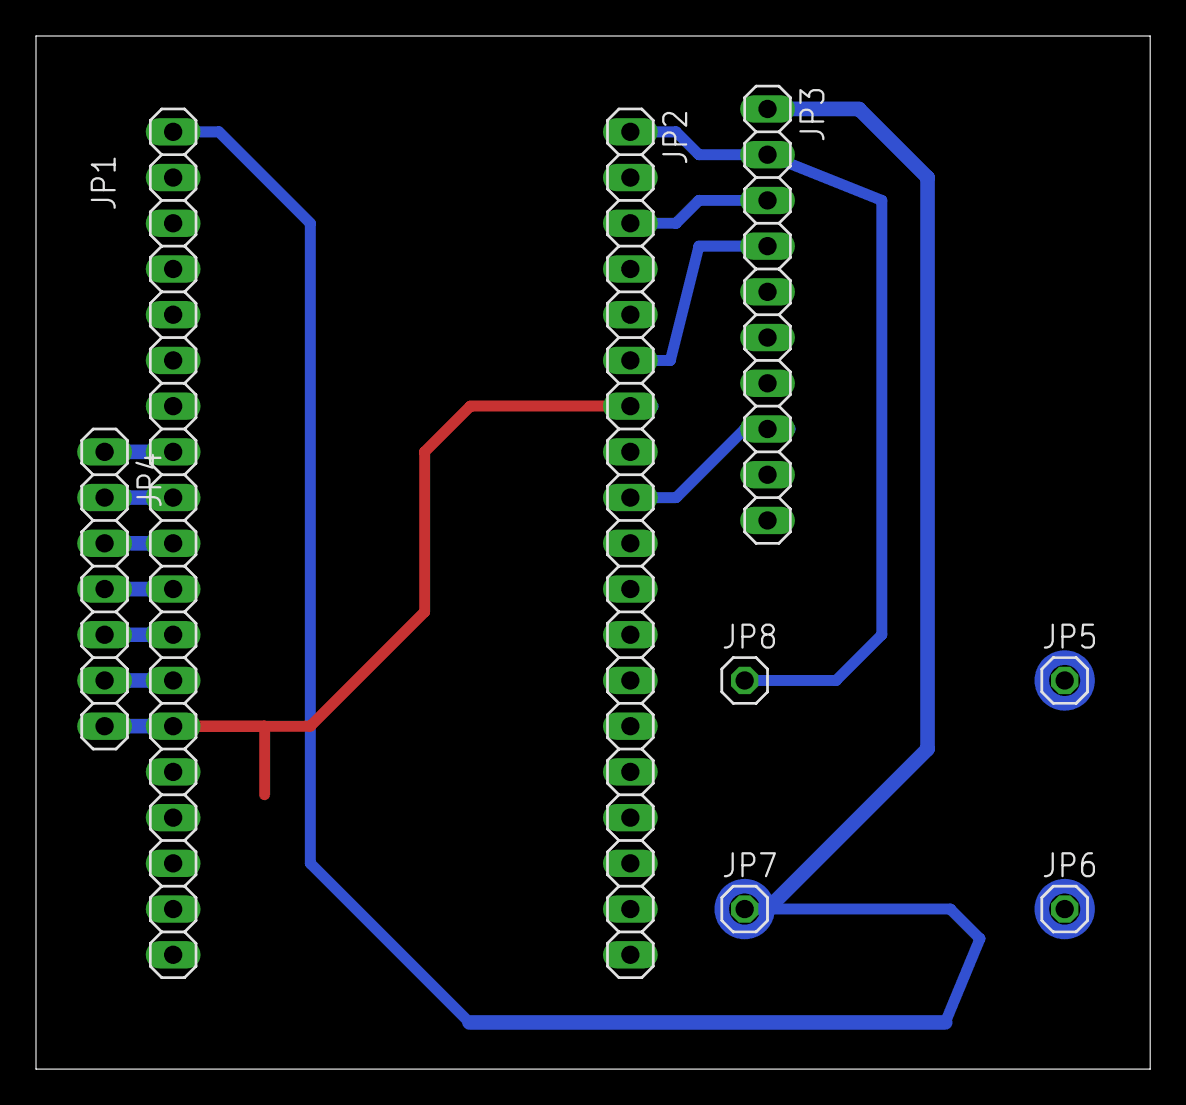
[picture p124: board esp32_hr_module.brd from above]

Board: 2 copper layers, 61.9 x 57.4 mm, 8 parts (0 on the bottom side), 11 nets.
