moisesStevend/Health-Recover/DESARROLLO TECNOLOGICO/PCB/HR/version1.brd

## EAGLE design DESARROLLO TECNOLOGICO/PCB/HR/version1.brd (2020-06-16)

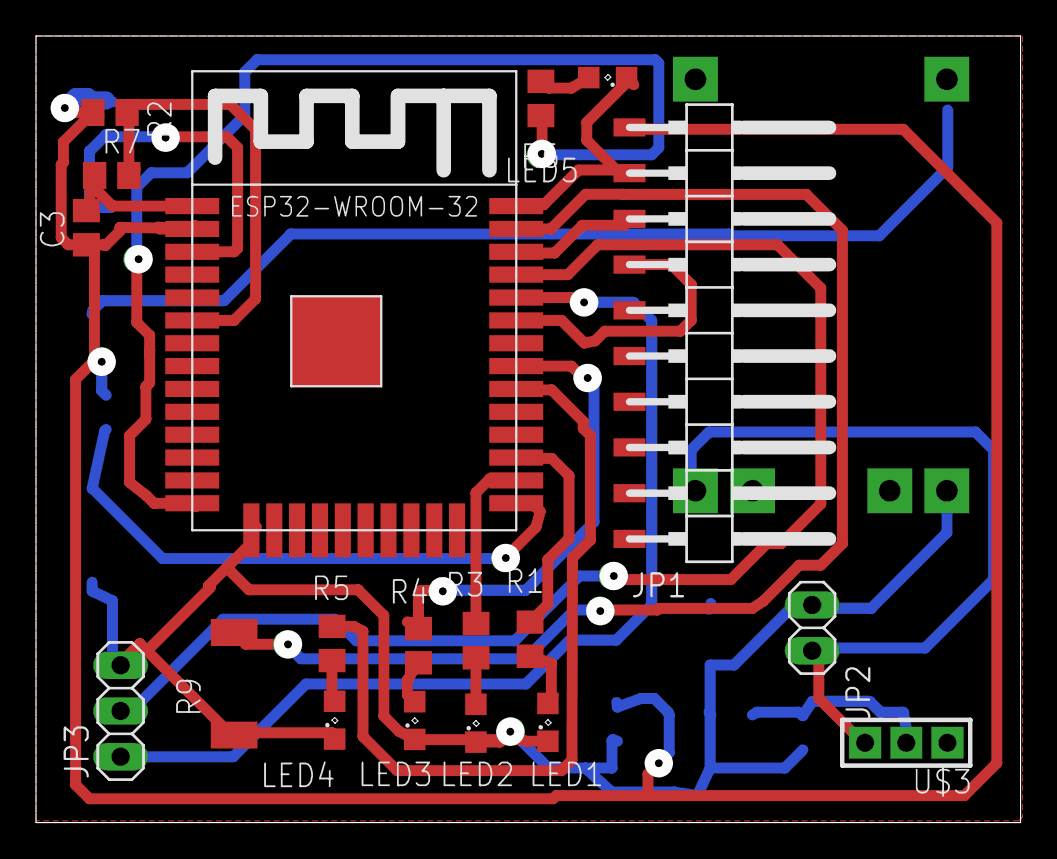
[picture p125: board version1.brd from above]

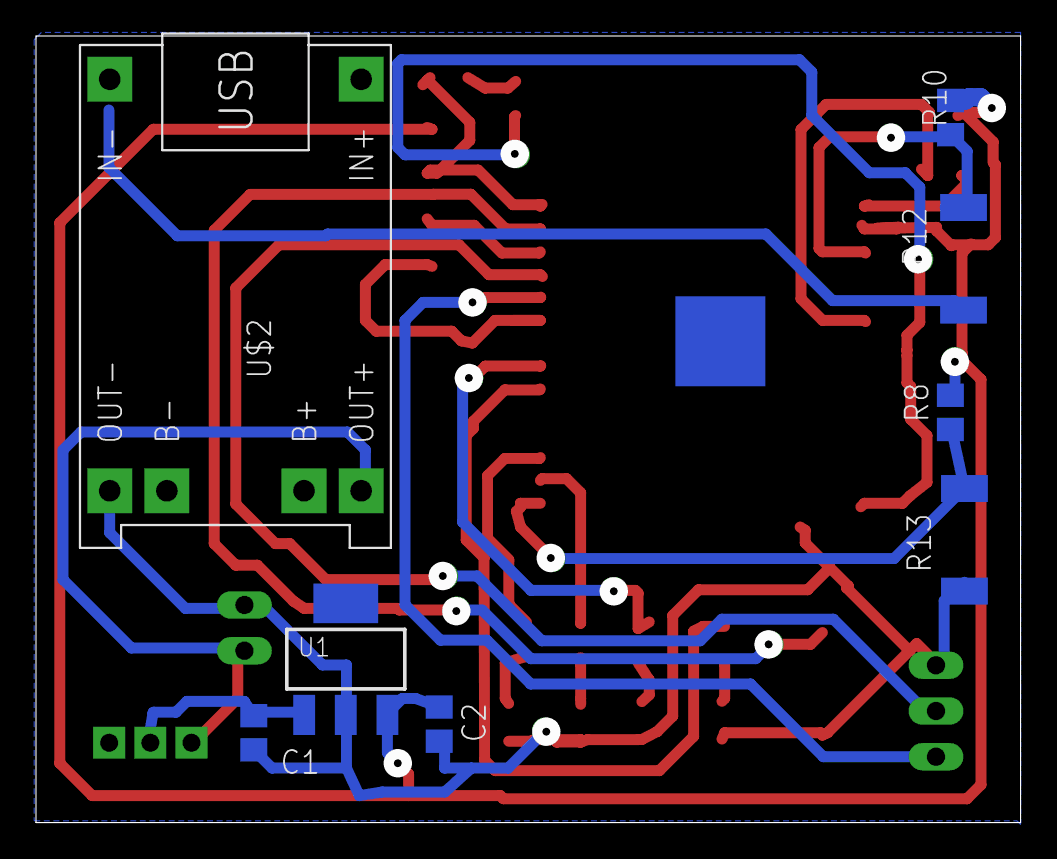
[picture p126: board version1.brd from below]

Board: 2 copper layers, 54.7 x 43.7 mm, 27 parts (8 on the bottom side), 23 nets.

Parts:
C1, C2, C3: 10uf; C0805
JP1: 1X10SMD/90
JP2: 1X02
JP3: 1X03
LED1, LED2, LED3, LED4, LED5: SML0805
R1, R3, R4, R5, R6: 330; R0805
R2, R7, R8, R10: 10k; R0805
R9, R12, R13: M2309
U1: TC1262_VDB; SOT-223-3
U$1: ESP32-WROOM
U$2: BATTERY-CHARGER-LI-PROT
U$3: -MICROSW; CON3

Connections:
ADC34: R2.1, R7.2, U$1.IO34
BAT0: R1.2, U$1.IO16
BAT1: R3.2, U$1.IO4
BAT2: R4.2, U$1.IO19
BAT3: R5.2, U$1.IO18
BUTTON: R9.2, U$1.IO23
EN: R10.1, R12.2, U$1.EN
GND: C1.2, C2.2, C3.2, JP1.2, JP2.2, JP3.3, LED1.C, LED2.C, LED3.C, LED4.C, LED5.C, R7.1, R9.1, R12.1, R13.1, U$1.GND1, U$1.GND2, U$1.GND3, U$1.GND4, U$1.GND5, U$2.OUT-
INDICATOR: R6.2, U$1.IO12
IO0: R8.1, R13.2, U$1.IO0
unnamed: LED5.A, R6.1
unnamed: JP2.1, U$2.OUT+, U$3.P$3
unnamed: LED1.A, R1.1
unnamed: LED2.A, R3.1
unnamed: LED3.A, R4.1
unnamed: LED4.A, R5.1
unnamed: C1.1, U1.1, U$3.P$2
RX: JP3.1, U$1.RX
SCL: JP1.3, U$1.IO22
SDA: JP1.4, U$1.IO21
TAB: U1.2, U1.4
TX: JP3.2, U$1.TX
VCC: C2.1, C3.1, JP1.1, R2.2, R8.2, R10.2, U1.3, U$1.3V3
