moisesStevend/Health-Recover/DESARROLLO TECNOLOGICO/PCB/_old_HR1/hr.brd

## EAGLE design DESARROLLO TECNOLOGICO/PCB/_old_HR1/hr.brd (2020-05-18, an earlier design)

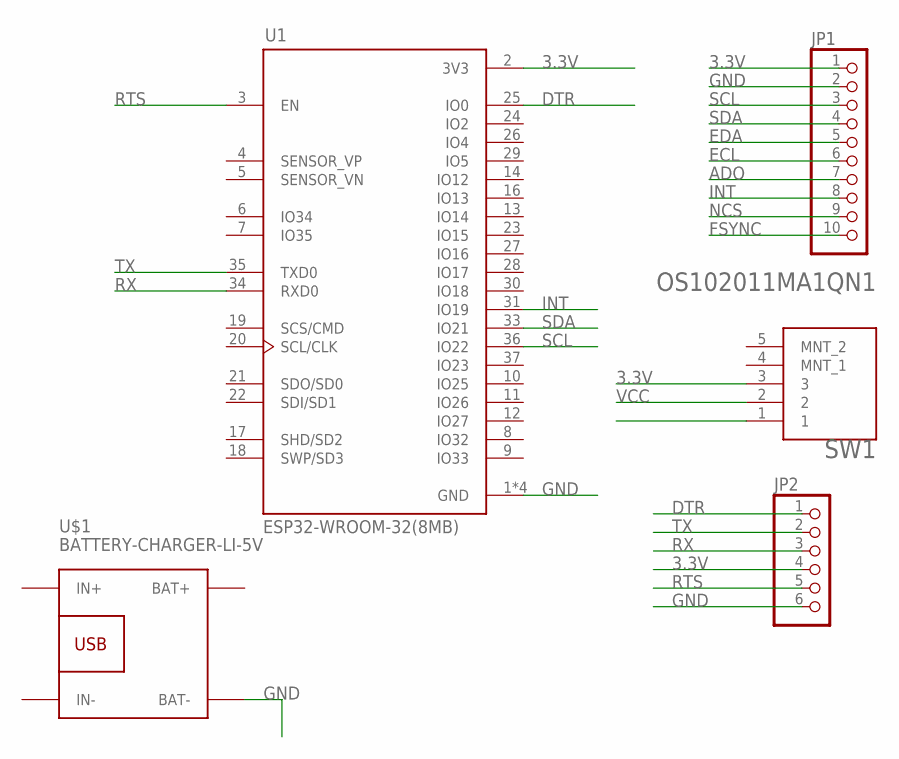
[picture p127: schematic hr.sch]

Parts:
JP1: PINHD-1X10; 1X10
JP2: PINHD-1X6; 1X06
SW1: C&K_OS102011MA1QN1C&K_OS102011MA1QN1_0_0; C&K_OS102011MA1QN1_0
U1: ESP32-WROOM-32(8MB); MODULE_ESP32-WROOM-32(8MB)
U$1: BATTERY-CHARGER-LI-5V

Connections:
3.3V: JP1.1, JP2.4, SW1.3, U1.2 (3V3)
ADO: JP1.7
DTR: JP2.1, U1.25 (IO0)
ECL: JP1.6
EDA: JP1.5
FSYNC: JP1.10
GND: JP1.2, JP2.6, U1.1 (GND), U1.15 (GND), U1.38 (GND), U1.39 (GND), U$1.BAT-
INT: JP1.8, U1.31 (IO19)
NCS: JP1.9
RTS: JP2.5, U1.3 (EN)
RX: JP2.3, U1.34 (RXD0)
SCL: JP1.3, U1.36 (IO22)
SDA: JP1.4, U1.33 (IO21)
TX: JP2.2, U1.35 (TXD0)
VCC: SW1.2

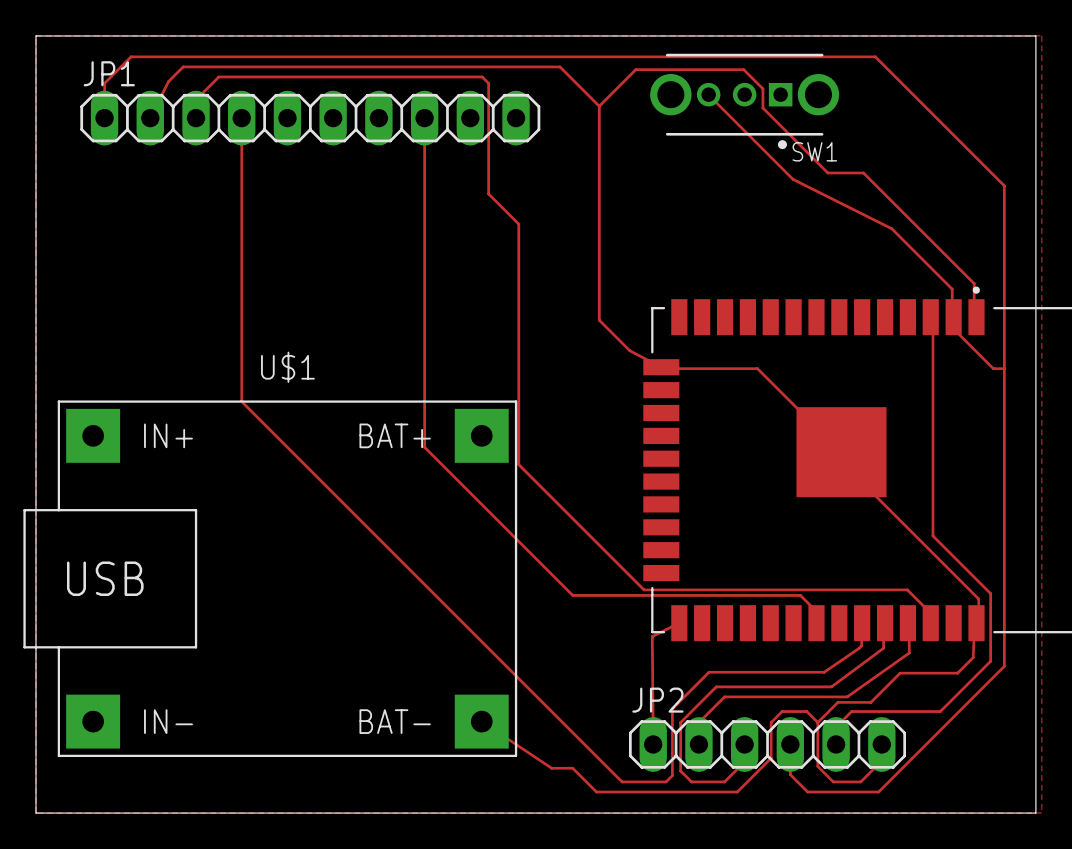
[picture p128: board hr.brd from above]

Board: 2 copper layers, 55.5 x 43.2 mm, 5 parts (0 on the bottom side), 9 nets.
