moisesStevend/Health-Recover/DESARROLLO TECNOLOGICO/PCB/_old_HR_2/modulev2.brd

## EAGLE design DESARROLLO TECNOLOGICO/PCB/_old_HR_2/modulev2.brd (2020-05-18, an earlier design)

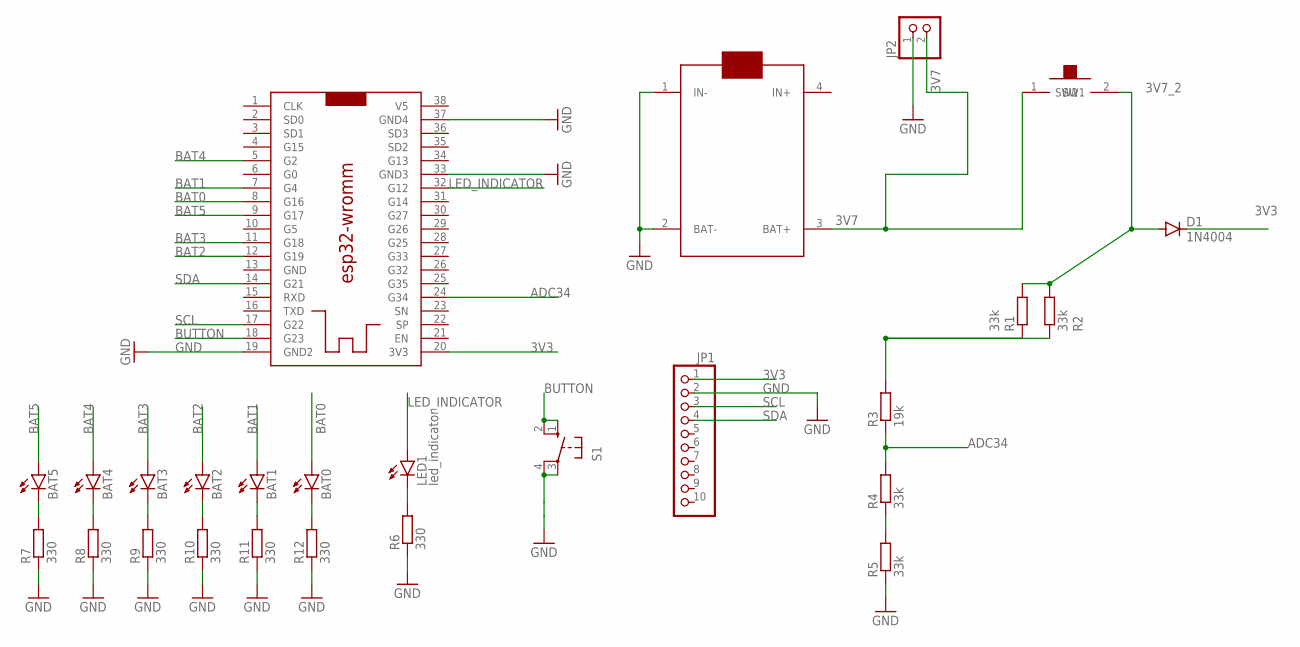
[picture p129: schematic modulev2.sch]

Parts:
BAT0, BAT1, BAT2, BAT3, BAT4, BAT5: led_indicator; LED3MM
D1: 1N4004; DO41-10
JP1: PINHD-1X10; 1X10
JP2: PINHD-1X2; 1X02
LED1: led_indicator; LED3MM
R1, R2, R4, R5: 33k; 0204/7
R3: 19k; 0204/7
R6, R7, R8, R9, R10, R11, R12: 330; 0204/7
S1: 10-XX; B3F-10XX
U$1: ESP32-WROMM2; ESP32-WORMM2
U$2: CHARGET_MODULE
U$3: MINI_SWITCH

Connections:
3V3: D1.C, JP1.1, U$1.20 (3V3)
3V7: JP2.2, U$2.3 (BAT+), U$3.1 (SW1)
3V7_2: D1.A, R1.2, R2.2, U$3.2 (SW2)
ADC34: R3.1, R4.2, U$1.24 (G34)
BAT0: BAT0.A, U$1.8 (G16)
BAT1: BAT1.A, U$1.7 (G4)
BAT2: BAT2.A, U$1.12 (G19)
BAT3: BAT3.A, U$1.11 (G18)
BAT4: BAT4.A, U$1.5 (G2)
BAT5: BAT5.A, U$1.9 (G17)
BUTTON: S1.1 (S), S1.2 (S1), U$1.18 (G23)
GND: JP1.2, JP2.1, R5.1, R6.1, R7.1, R8.1, R9.1, R10.1, R11.1, R12.1, S1.3, S1.4 (P1), U$1.19 (GND2), U$1.33 (GND3), U$1.37 (GND4), U$2.1 (IN-), U$2.2 (BAT-)
LED_INDICATOR: LED1.A, U$1.32 (G12)
unnamed: R4.1, R5.2
unnamed: LED1.K (C), R6.2
unnamed: BAT5.K (C), R7.2
unnamed: R1.1, R2.1, R3.2
unnamed: BAT4.K (C), R8.2
unnamed: BAT3.K (C), R9.2
unnamed: BAT2.K (C), R10.2
unnamed: BAT1.K (C), R11.2
unnamed: BAT0.K (C), R12.2
SCL: JP1.3, U$1.17 (G22)
SDA: JP1.4, U$1.14 (G21)

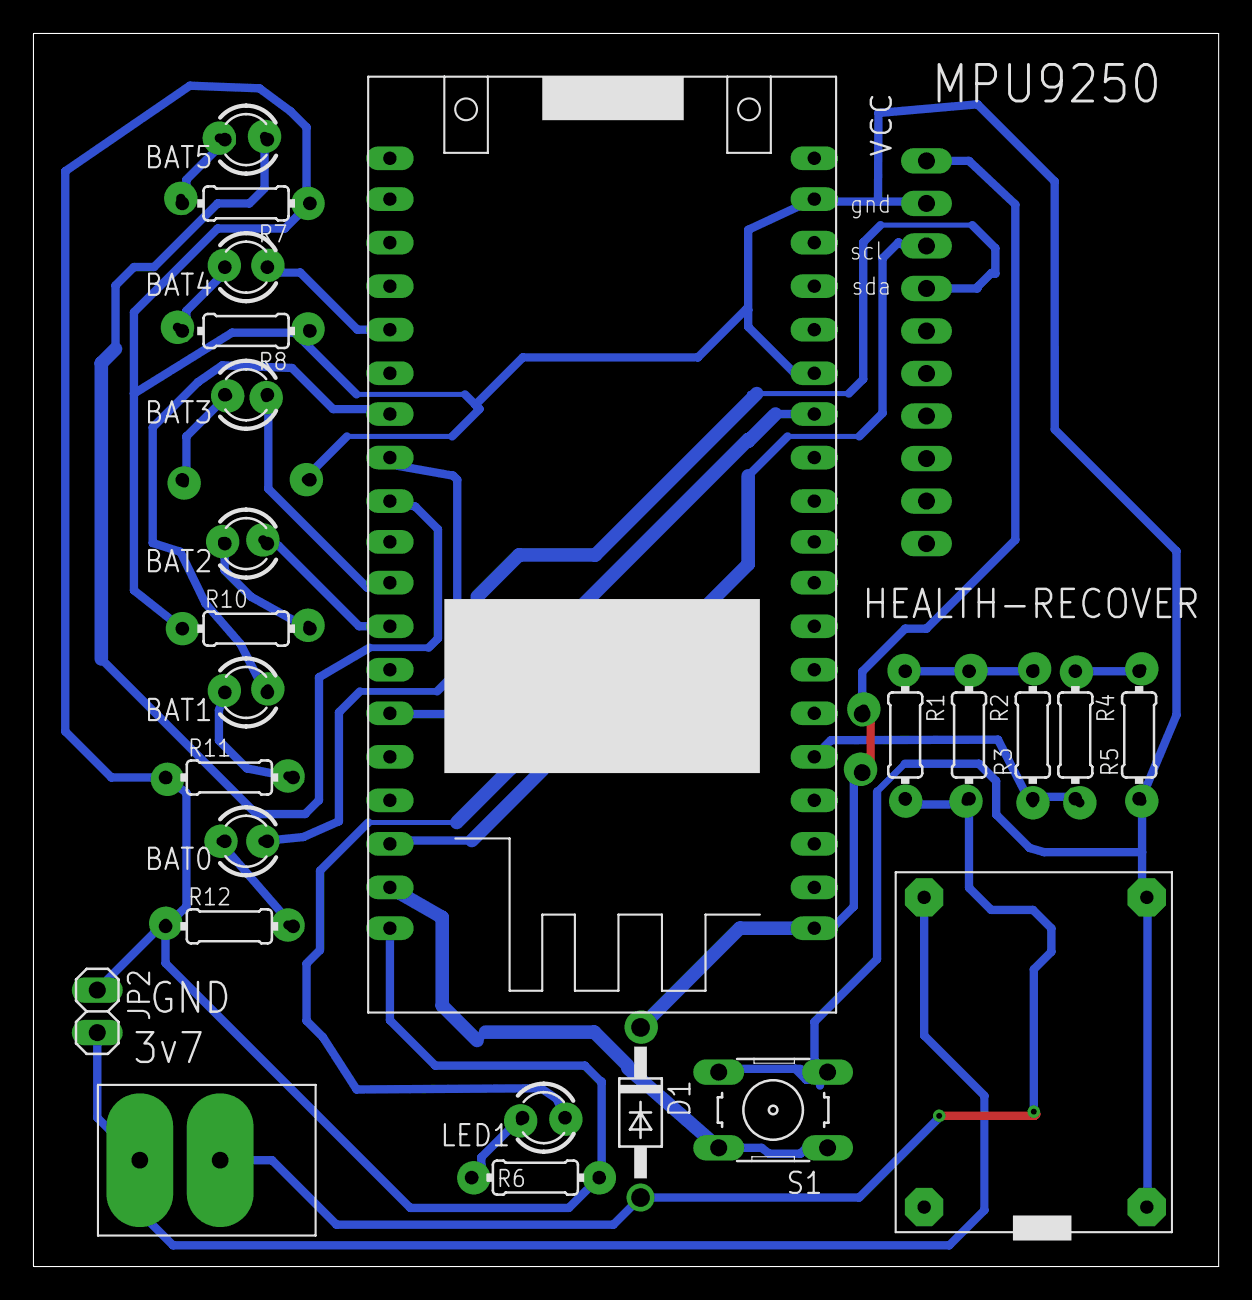
[picture p130: board modulev2.brd from above]

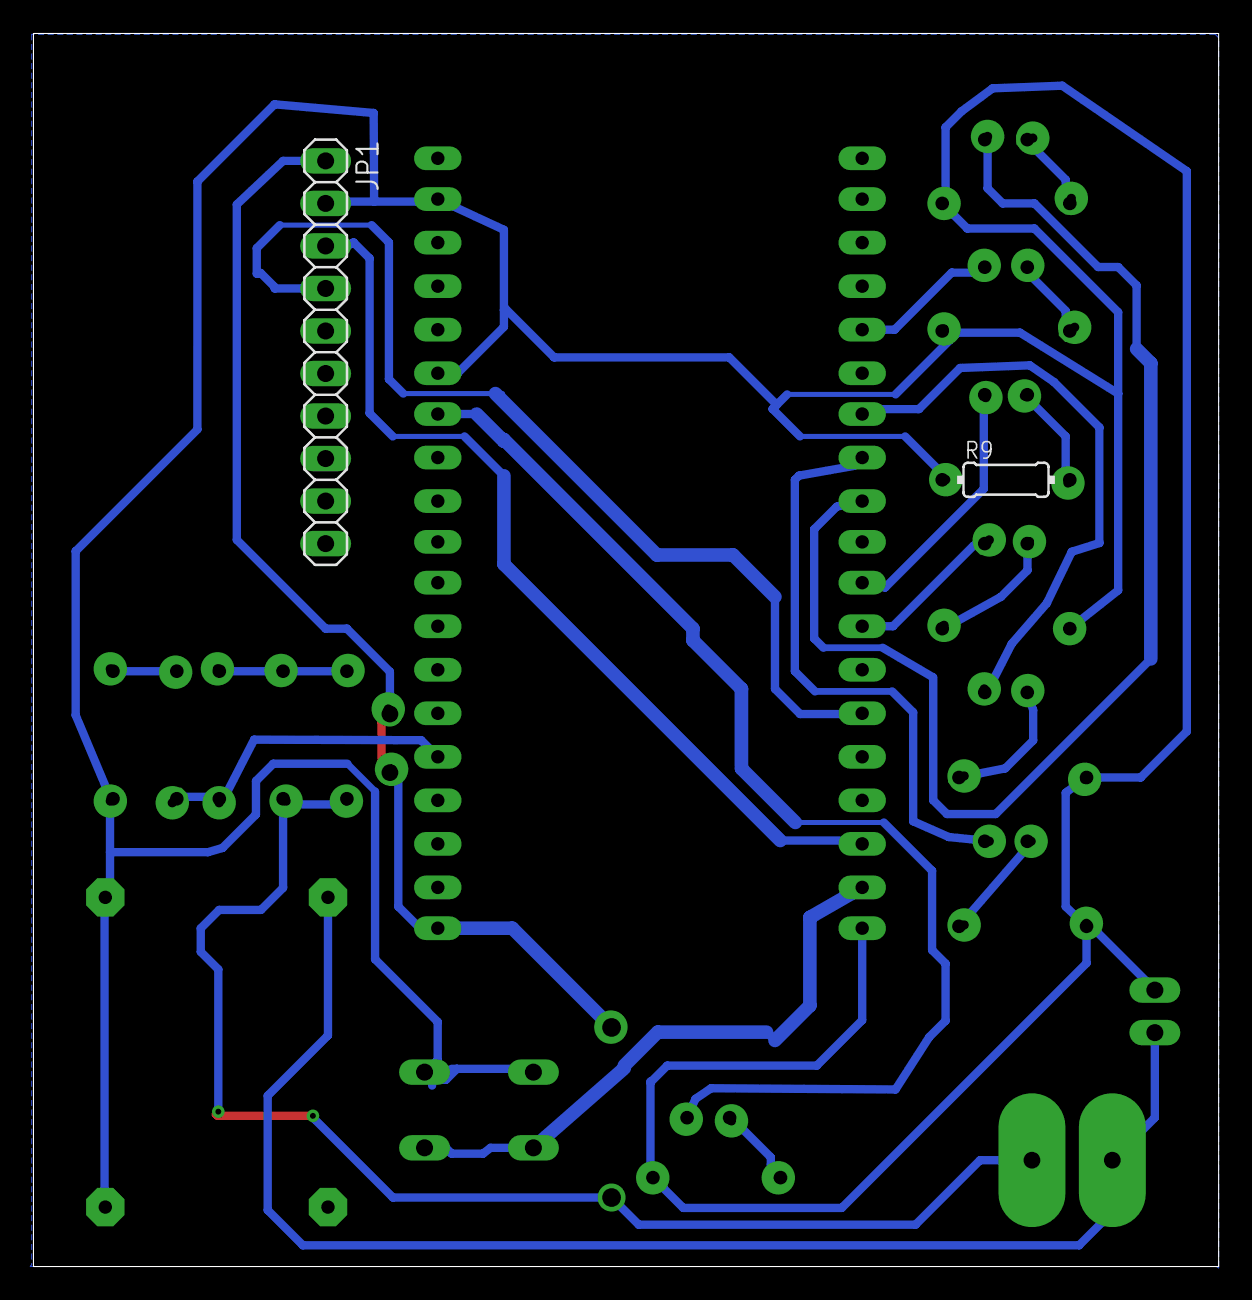
[picture p131: board modulev2.brd from below]

Board: 2 copper layers, 70.8 x 73.7 mm, 26 parts (2 on the bottom side), 24 nets.
