moisesStevend/Health-Recover/_old_HR/PCB_HW_2017/UPCH.brd

## EAGLE design _old_HR/PCB_HW_2017/UPCH.brd (2020-05-19, an earlier design)

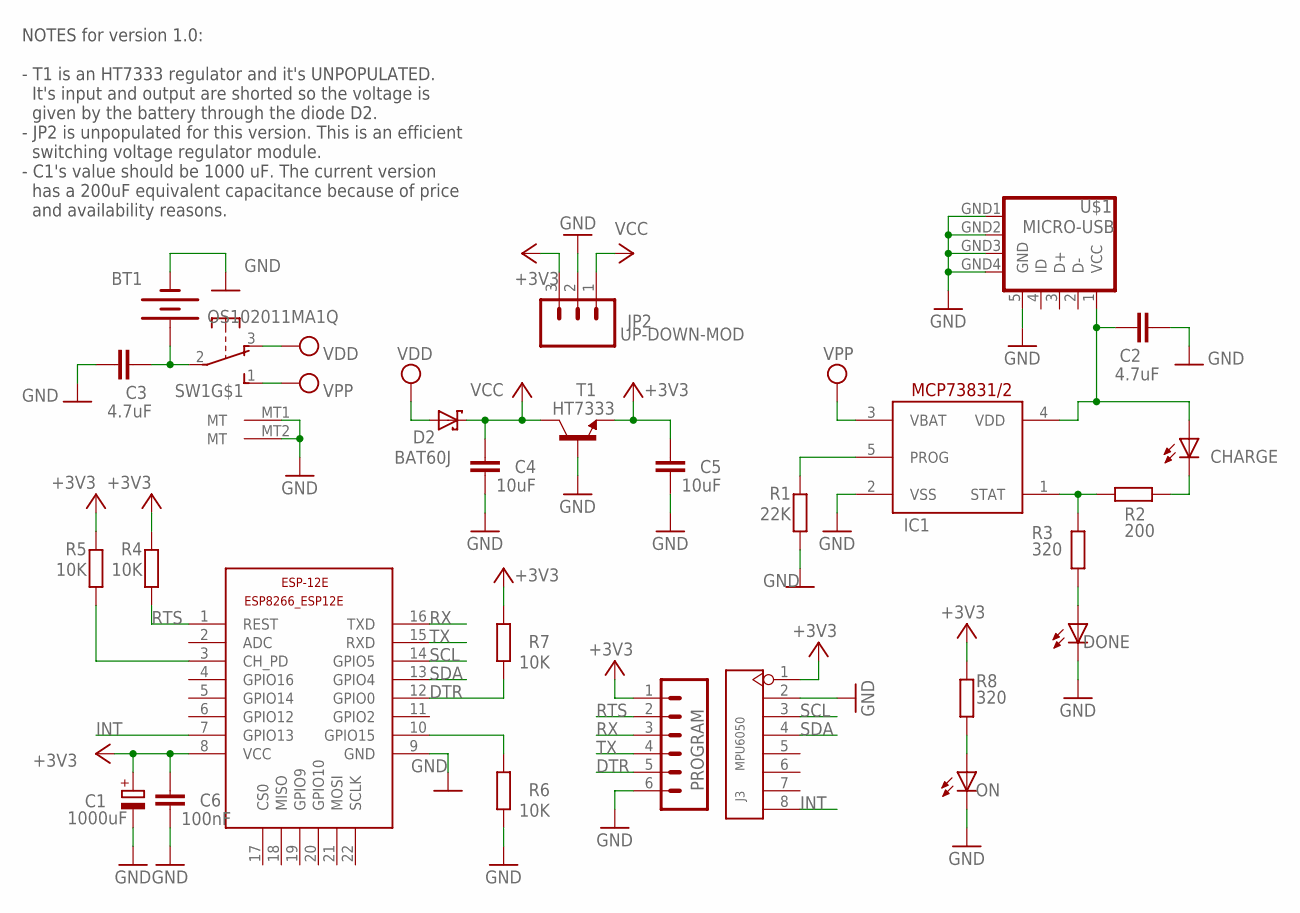
[picture p132: schematic UPCH.sch]

Parts:
BT1: BATTERY24.5MM; BATTCON_24.5MM
C1: 1000uF; D/7343-31W
C2, C3: 4.7uF; C1206
C4, C5: 10uF; C1206
C6: 100nF; C1206
CHARGE: LEDCHIP-LED0603; CHIP-LED0603
D2: BAT60J; SOD323_ST
DONE: LEDCHIP-LED0603; CHIP-LED0603
ESP-12E: ESP8266-12EESP8266-ESP12E; ESP8266-ESP12E
IC1: MCP73831; SOT23-5L
J3: MPU6050; H8-SMD-2.54-90D
JP2: UP-DOWN-MOD; 1X03
ON: LEDCHIP-LED0603; CHIP-LED0603
PROGRAM: CONN_06SILK_FEMALE_PTH; 1X06
R1: 22K; R0603
R2: 200; R1206
R3, R8: 320; R0603
R4, R5, R6: 10K; R0603
R7: 10K; R1206
SW1: OS102011MA1Q
T1: HT7333; SOT89-BCE
U$1: MICRO-USB

Connections:
+3V3: C1.+, C5.1, C6.1, ESP-12E.8 (VCC), J3.1, JP2.3, PROGRAM.1, R4.2, R5.2, R7.2, R8.1, T1.E
DTR: ESP-12E.12 (GPIO0), PROGRAM.5, R7.1
GND: BT1.2 (-), C1.-, C2.2, C3.2, C4.2, C5.2, C6.2, DONE.C, ESP-12E.9 (GND), IC1.2 (VSS), J3.2, JP2.2, ON.C, PROGRAM.6, R1.1, R6.1, SW1.MT1 (MT), SW1.MT2 (MT), T1.B, U$1.5 (GND), U$1.GND1 (GND), U$1.GND2 (GND), U$1.GND3 (GND), U$1.GND4 (GND)
INT: ESP-12E.7 (GPIO13), J3.8
unnamed: DONE.A, R3.2
unnamed: IC1.5 (PROG), R1.2
unnamed: CHARGE.C, R2.2
unnamed: BT1.1 (+), C3.1, SW1.2
unnamed: IC1.1 (STAT), R2.1, R3.1
unnamed: ESP-12E.3 (CH_PD), R5.1
unnamed: ESP-12E.10 (GPIO15), R6.2
unnamed: ON.A, R8.2
unnamed: C2.1, CHARGE.A, IC1.4 (VDD), U$1.1 (VCC)
RTS: ESP-12E.1 (REST), PROGRAM.2, R4.1
RX: ESP-12E.16 (TXD), PROGRAM.3
SCL: ESP-12E.14 (GPIO5), J3.3
SDA: ESP-12E.13 (GPIO4), J3.4
TX: ESP-12E.15 (RXD), PROGRAM.4
VCC: C4.1, D2.C, JP2.1, T1.C
VDD: D2.A, SW1.3 (O)
VPP: IC1.3 (VBAT), SW1.1 (S)

Notes on the sheet:
NOTES for version 1.0: - T1 is an HT7333 regulator and it's UNPOPULATED. It's input and output are shorted so the voltage is given by the battery through the diode D2. - JP2 is unpopulated for this version. This is an efficient switching voltage regulator module. - C1's value should be 1000 uF. The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

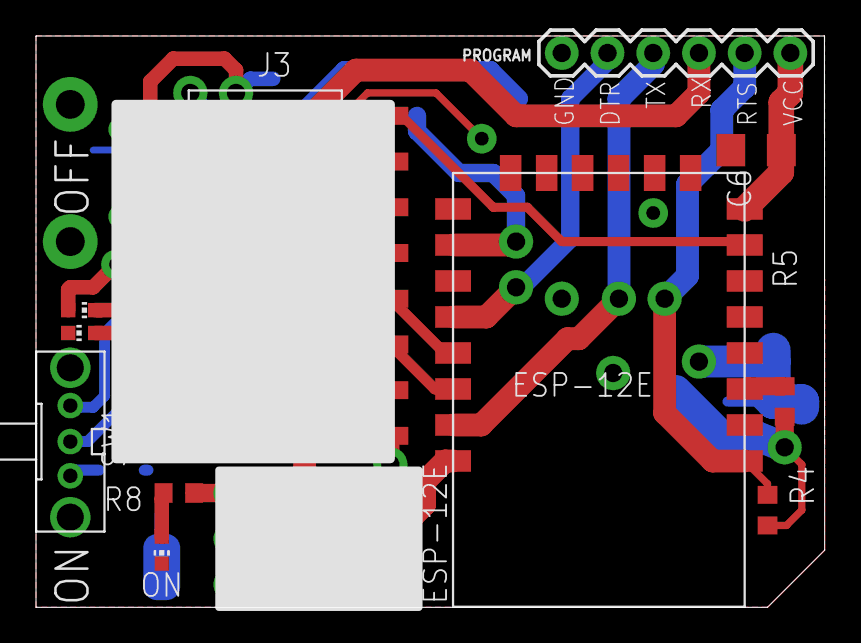
[picture p133: board UPCH.brd from above]

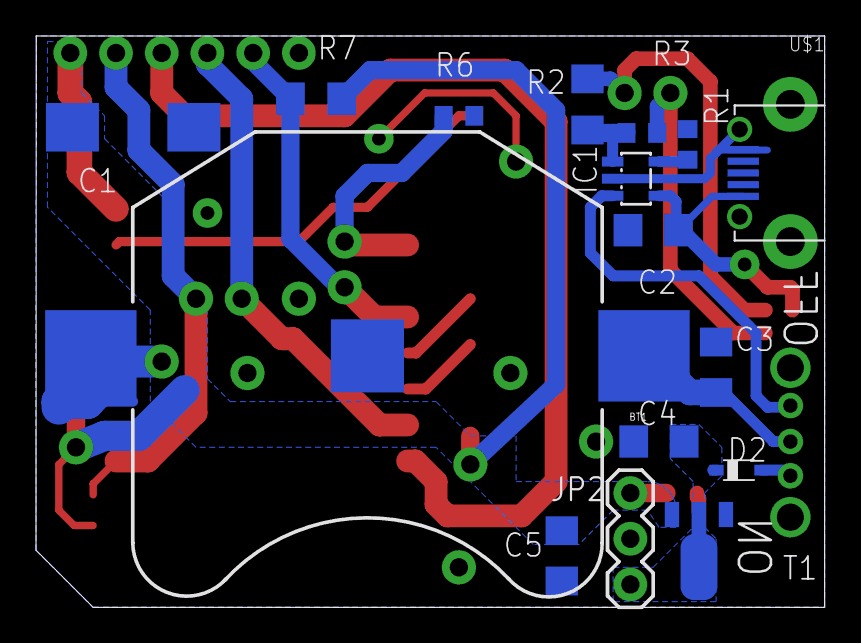
[picture p134: board UPCH.brd from below]

Board: 2 copper layers, 43.8 x 31.7 mm, 27 parts (16 on the bottom side), 21 nets.
