moisesStevend/Health-Recover/(commit log)

2020-05-18 design layout and schematic
    [esp32_hr_module.brd, esp32_hr_module.sch, hr.brd, hr.sch, modulev2.brd, modulev2.sch, version1.brd, version1.sch]
2020-05-19 Fotos y diseños
    [UPCH.brd, UPCH.sch, cotizacion_smd.xlsx]
2020-06-16 new documents
    [version1.brd]
2020-06-16 reestructuración de archivos
    [HR_v2.FCStd, HR_v2_parte_inferior.FCStd, cotizacion_smd.xlsx, esp32_hr_module.brd, esp32_hr_module.sch, hr.brd, hr.sch, modulev2.brd]
2020-06-24 add new features
    [HR_v2.FCStd, HR_v2_parte_inferior.FCStd, cotizacion_smd.xlsx, parte_inferior.stl]
